s070388s/dib-dcp405plus-/Images/DCP405plus.jpg

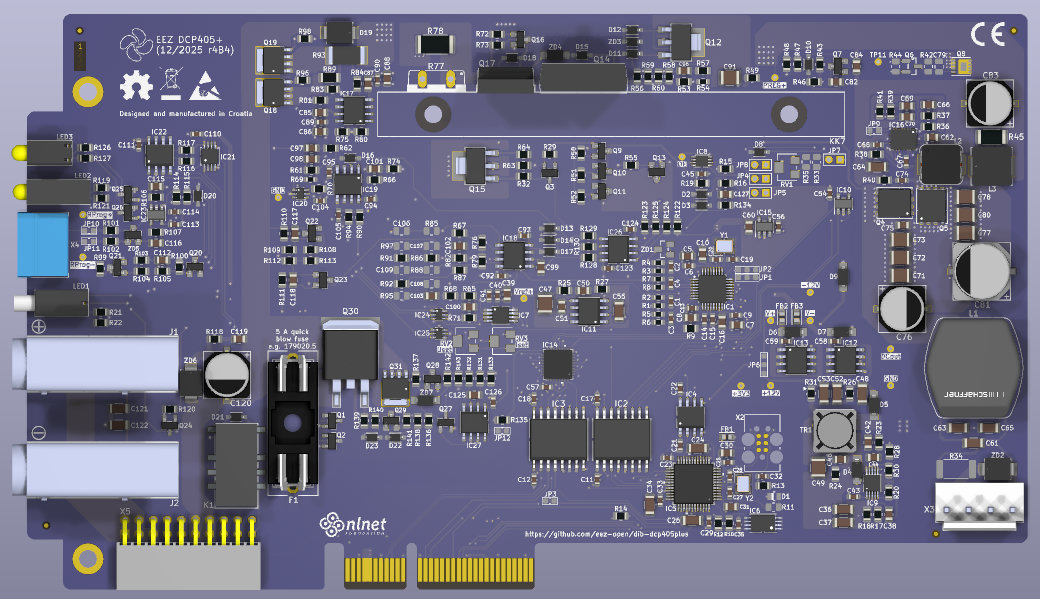
Images/DCP405plus.jpg
