s070388s/dib-dcp405plus-/fabrication/bom/EEZ DIB DCP405plus.pdf

EEZ DIB DCP405plus

# | Reference | Value | Qty | DigiKey | Mouser | TME | LCSC

1 | C14 | 270n | 1
2 | C44 | 33p | 1 | 1276-1105-1-ND | C0805C330K5GACTU | CL21C330JBANNNC
3 | C68 | 15p | 1 | 399-C0603C150J5GAC7867TR-ND 80-C0603C150J5G | C0603C150J5GAC
4 | C81 | EEEFK1J101P | 1 | PCE3819CT-ND | 667-EEE-FK1J101P | EEEFK1J101P
5 | C82 | 470p | 1 | 732-7837-1-ND | 710-885012007038 | CC0805JRNPO9BN471
6 | C97 | 6n8 | 1 | 1276-1799-1-ND | 80-C0805C682K5R | CL21B682KBANNNC
7 | C120 | 33u/50V poly. | 1 | | | - | C2157841
8 | C1,C2,C3,C4,C32,C74 | 1n | 6 | 732-7858-1-ND | 80-C0603C102K5R7040 C0805C102J5GAC
9 | C100,C101,C112 | 2n2 | 3 | 399-C0805C222K5RAC7210TR-ND 80-C0805C222K5RACLR
10 | C19,C20 | 10p | 2 | 1276-1069-1-ND | 187-CL10C100CB8NNNC VJ0603A100JXACW1BC C318677
11 | C24,C26,C36,C37,C64 | 2u2 | 5 | 1276-3138-1-ND | 187-CL31B225KCHSNNE C3216X7S2A225KAB
12 | C27,C28 | 30p | 2 | 1292-1515-1-ND | 80-C0603C300G5HACTU 0603N300J500CT | C123555
13 | C34,C48,C52,C53,C55 | 4u7 | 5 | 1276-2970-1-ND | 963-EMK316B7475ML-T GCM31CR71E475KA55L
14 | | 10n | 9 | 490-7194-1-ND | 710-885012207122 | CC0805KRX7R9103
15 | C46,C102 | 330p | 2 | 1276-1189-1-ND | 80-C0805C331J5G | CL21C331JBANNNC
16 | C47,C49 | 22u | 2
17 | | 1u | 14 | 587-1283-1-ND | | CL21B105KOFNNNE
18 | | 100n | 40 | 490-4774-1-ND | 80-C0603C104M4R | CL10B104KA8NNNC
19 | C61,C63,C65,C121,C122 | 10n/200V | 5 | 311-4491-1-ND | 603-C1206KRX7RABB103 VJ1206Y103KXCTW1BC
20 | C62,C75,C119 | 470n | 3 | 1276-6482-1-ND | 603-CC805KKX7R9BB474 CL21B474KBFNNNE
21 | C70,C103 | 150p | 2 | 1276-1828-1-ND | 80-C0805C151J5G | CC0805JRNPO9BN151
22 | C71,C72,C73,C91 | 4u7/100V | 4 | 587-5034-1-ND | 810-CGA6M3X7S2A475K -
23 | C76,C83 | EEEFK1H470P | 2 | PCE3815CT-ND | 667-EEE-FK1H470P | EEEFK1H470P
24 | C77,C78,C80 | 10u | 3 | 1276-6736-1-ND | 810-C3216X7R1HK160AC CL31A106KBHNNNE
25 | C98,C125,C127 | 4n7 | 3 | 732-12255-1-ND | 810-C2012C0G1H472J-1 GRM2165C1H472JA01D
26 | C99,C115,C116 | 100p | 3 | 399-15000-1-ND | 80-C0805C101K5G | CL21C101JBANNNC
27 | D19 | SK55 | 1 | SK56A-LTPMSCT-ND | 833-SK56A-LTP | SK55-DIO
28 | | BAS316 | 16 | 1727-7370-1-ND | 771-BAS316-T/R | BAS316,115
29 | D4,D5,D6,D7,D9 | SKL16 | 5 | RB160MM-60CT-ND | 755-RB160MM-60TR | SKL16-DIO
30 | F1 | ZH32 | 1 | 732-11370-ND | 710-696101000002 | ZH32
31 | FB1,FB2,FB3 | BLM18AG102SH1D | 3 | 490-7809-1-ND | 81-BLM18AG102SH1D | BLM18AG102SH1D
32 | IC1 | ADS131A04IPBSR | 1 | 296-44202-1-ND | 595-ADS131A04IPBSR | - | C882747
33 | IC4 | ISO6520DR | 1 | 296-ISO6520DRCT-ND | 595-ISO6520DR | - | C32273056

565-HHXD630ARA330MHA0GCT-ND

661-
XD630ARA330MHA0G

C38,C42,C66,C69,C85,C87,C96,C117,C 118

C5,C7,C8,C10,C16,C30,C31,C39,C50,C 51,C60,C84,C86,C88

603-
CC805MKX7R7BB105
C6,C9,C11,C12,C13,C15,C17,C18,C21, C22,C23,C25,C29,C33,C35,C40,C41,C4 3,C45,C54,C56,C57,C58,C59,C67,C89, C90,C92,C93,C94,C95,C104,C105,C110 ,C111,C113,C114,C123,C124,C126

D2,D3,D8,D10,D11,D12,D13,D14,D15,D 16,D17,D18,D20,D21,D22,D23

34 | IC5 | STM32H503CBT6 | 1 | 497-STM32H503CBT6-ND | 511-STM32H503CBT6 | STM32H503CBT6 | C17700273
35 | IC6 | M24C32-DFDW6TP | 1 | 497-16067-1-ND | 511-M24C32-DFDW6TP M24C32-DFDW6TP | C2971426
36 | IC7 | DAC8552IDGKR | 1 | 296-46082-1-ND | 595-DAC8552IDGKR | - | C136020
37 | IC8 | 74AUP1G74DC,125 | 1 | 1727-6029-2-ND | 771-AUP1GDC125 | 74AUP1G74DC.125 | C458192
38 | IC9 | TPS54060DGQ | 1 | 296-37148-1-ND | TPS54060ADGQR | - | C12382
39 | IC10 | TC77-5.0MCTTR | 1 | TC77-5.0MCTTRCT-ND | 579-TC77-5.0MCTTR | TC77-5.0MCTTR | C145382
40 | IC11 | REF5025AIDR | 1 | 296-39165-1-ND | 595-REF5025AIDR | - | C11341
41 | IC12 | MC79L05 | 1 | MC79L05ABDGOS-ND | 863-MC79L05ACDR2G | MC79L05ACDG | C232661
42 | IC13 | MC78L05 | 1 | MC78L05ACDR2GOSCT-ND | 863-MC78L05ACDR2G | MC78L05ACDG | C7371
43 | IC14 | PCAL9722HNMP | 1 | 568-PCAL9722HNMPTR-ND | 771-PCAL9722HNMP | - | C24212503
44 | IC15 | TPS7A2033PDBVR | 1 | 296-TPS7A2033PDBVRCT-ND | 595-TPS7A2033PDBVR | TPS7A2033PDBVR | C2862740
45 | IC16 | LM5145RGYR | 1 | 296-47661-1-ND | 595-LM5145RGYR | - | C485912
46 | IC17 | LTC2050HVCS8#PBF | 1 | LTC2050HVCS8#PBF-ND | 584-LTC2050HVCS8#PBF - | C679141
47 | IC21 | SN74LVC2G08DCTR | 1 | 296-13263-2-ND | 595-SN74LVC2G08DCTR SN74LVC2G08DCTR | C352973
48 | IC23 | OPA376AIDBVR | 1 | 296-39130-2-ND | 595-OPA376AIDBVR | OPA376AIDBVR | C42134
49 | IC27 | MAX9141ESA | 1 | MAX9141ESA+-ND | 700-MAX9141ESA | - | C3658498
50 | IC18,IC19 | TL072D | 2 | 296-1282-1-ND | 595-TL072CDR | TL072CD-ST | C67473
51 | IC2,IC3 | ISO6762FDWR | 2 | 296-ISO6762FDWRCT-ND | 595-ISO6762FDWR | - | C5216396
52 | IC20,IC24,IC25 | SN74LVC1G3157DCKR | 3 | 296-14909-1-ND | SN74LVC1G3157DCKR C38663
53 | IC22,IC26 | LM293D | 2 | LM293DR2GOSCT-ND | 863-LM293DR2G | LM293DR | C76509
54 | J1 | 572-0500 | 1 | - | 164-6221 | 572-0500 | -
55 | J2 | 572-0100 | 1 | - | 164-6220 | 572-0100 | -
56 | K1 | | 1 | 399-10997-1-ND | 80-EE2-12NU-L | FTR-C1GA012G-B05 | C147864
57 | KK7 | SK96/84 | 1 | 5496-SK9684SA-ND | - | SK96/84SA | -
58 | KK8 | SP400-0.007-00-104 | 1 | BER204-ND | 951-SP400-007-00-104
59 | KK1,KK2 | PCB-MB-01 | 2 | RPC1760-ND | 144-PCB-MB-01 | RI-PCB-MB-01
60 | KK3,KK4,KK5,KK9 | M3X8/D7985B | 4 | - | - | M3X8/D7985B
61 | KK6,KK10 | B3/BN2842 | 2 | - | - | B3/BN2842
62 | L1 | RN112-4-02-0M7 | 1 | 817-2100-ND | 631-RN112-4-02-0M7 | -
63 | L2 | ETQ-P4M100KFM | 1 | P124167CT-ND | 667-ETQ-P4M100KFM | -
64 | L3 | HPI0630-3R3 | 1 | 445-180834-1-ND | 810-VLS6045AF-3R3N | HPI0630-3R3
65 | LED1 | WP42WUM/EGW | 1 | 754-1718-ND | 604-WP42WUM/EGW | L-42WUM/1EGWT
66 | LED2 | SSF-LXH340LYGID | 1 | SSF-LXH340LYGID-ND | 696-SSFLXH340LYGID | - | C17285042
67 | LED3 | WP934MD/LYLID | 1 | 350-2716-ND | 604-WP934MDLYLID | - | -
68 | Q4 | BSC117N08NS5ATMA1 | 1 | BSC117N08NS5ATMA1CT-ND | BSC117N08NS5ATMA1 C3278730
69 | Q5 | BSC039N06NSATMA1 | 1 | BSC039N06NSATMA1CT-ND | | BSC039N06NS | C6471340
70 | Q14 | IRFP250NPBF | 1 | IRFP250NPBF-ND | 942-IRFP250NPBF | IRFP250NPBF
71 | Q16 | BC857C | 1 | 4878-BC857CCT-ND | 637-BC857C | BC857C-DIO | C8666
72 | Q17 | IRFI9Z34GPBF | 1 | IRFI9Z34GPBF-ND | 844-IRFI9Z34GPBF | IRFI9Z34GPBF | C222460
73 | Q29 | FMMT493TA | 1 | FMMT493CT-ND | 522-FMMT493TA | FMMT493TA
74 | Q30 | BT139B-600E | 1 | 1740-1053-1-ND | 771-BT139B-600E118 | BT139B-600E.118 | C6533556

595-
SN74LVC1G3157DCK

FTR-C1GA012G-B05 or
EE2-12NU-L

726-
BSC117N08NS5ATMA
726-
BSC039N06NSATMA1

75 | Q31 | PSMN013-60YL | 1 | 1727-2589-1-ND | 771-PSMN013-60YLX | PSMN013-60YLX | C503662
76 | Q1,Q2,Q3 | BSS84 | 3 | BSS84LT1GOSCT-ND | 863-BSS84LT1G | BSS84LT1G | C82079
77 | Q12,Q15 | BCP56-16.115 | 2 | BCP5616QTADICT-ND | 621-BCP5616QTA | BCP56-16T1G
78 | Q18,Q19 | PSMN0R9-25YLC | 2 | 1727-5292-1-ND | 771-PSMN0R925YLC115 PSMN0R9-25YLC.115
79 | Q24,Q25,Q26,Q27 | 2N7002 | 4 | T2N7002AKLMCT-ND | 757-T2N7002AKLM | 2N7002LT1G
80 | Q7,Q10,Q11,Q23 | MMBT5401 | 4 | MMBT5401-FDICT-ND | 621-MMBT5401-F | MMBT5401-DIO | C21488
81 | Q9,Q13,Q20,Q21,Q22,Q28 | MMBT5551 | 6 | MMBT5551LT1GOSCT-ND | 637-MMBT5551 | MMBT5551-DIO | C41095
82 | R20 | 330K | 1 | A126361CT-ND | 652-CR0805FX-3303ELF 0805S8F3303T5E
83 | R45 | 15R | 1 | A129910CT-ND | 603-RC2010FK-0715RL | 201007J0150T4E
84 | R53 | 51K | 1
85 | R59 | 16K | 1
86 | R68 | 6K8 | 1
87 | R69 | 3K | 1
88 | R78 | 2R2/2-3W | 1 | CRM2512-JW-2R2ELFCT-ND | 279-35222R2JT | WF25P2R2JTL
89 | R89 | 1R 0.1% | 1 | 1712-CPF1206B1R0E1CT-ND | 279-CPF1206B1R0E1 | - | C4106088
90 | R93 | 0R010 | 1 | 846-GMR100HJBFA10L0CT-ND | GMR100HJBFA10L0 | - | -
91 | R141 | 6R2 | 1 | 311-6.20CRCT-ND | 603-RC0805FR-076R2L | RC0805JR-076R2
92 | R1,R2,R3,R4,R5,R6,R7,R8,R54 | 100R | 9 | 13-RC0603FR-10100RLCT-ND | 603-RT0603FRE07100RL RC0603FR-10100RL | C1512171
93 | | 2K2 | 10 | 311-2.20KCRCT-ND | 603-RC0805FR-072K2L | 0805S8F2201T5E
94 | R110,R111,R131 | 330R | 3 | A129743CT-ND | 652-CR0805FX-3300ELF 0805S8F3300T5E
95 | R116,R117,R134 | 4K7 | 3 | 311-4.70KCRCT-ND | 603-RC0805FR-074K7L | 0805S8F4701T5E
96 | | 10K | 26 | 311-10.0KCRCT-ND | 603-RC0805FR-0710KL | RC0805FR-1310KL
97 | R15,R29,R46,R120,R138 | 100K | 5 | RMCF0805FT100KCT-ND | 0805S8F1003T5E
98 | 47K | 9 | RHM47KKCT-ND | 603-RC0805FR-0747KL | RC0805FR-0747K
99 | R21,R60,R109,R112,R126,R127 | 750R | 6 | A126385CT-ND | 0805S8F7500T5E | C17818
100 | R22,R30,R75,R124,R125 | 6K2 | 5
101 | R23,R28 | 86K6 | 2 | 311-86.6KCRCT-ND | 603-RT0805FRE0786K6L CRCW080586K6FKTABC
102 | R27,R118 | 1R | 2 | -
103 | R38,R55,R61,R119 | 470R | 4 | 311-470CRCT-ND | 71-CRCW0805470RFKEB RC0805FR-07470R
104 | R41,R122,R123 | 3K9 | 3 | A126369CT-ND | 279-CRGP0805F3K9 | SMD0805-3K9-1%
105 | 1K | 12 | RC0805FR-071KL | 603-RC0805FR-071KL | RC0805FR-071K
106 | R50,R121 | 1K2 | 2
107 | R51,R52,R64,R94 | 220R | 4 | RMCF0805FT220RCT-ND | 603-RC0805FR-13220RL 0805S8F2200T5E
108 | R79,R82 | 7K5 0.1% | 2 | YAG1974CT-ND | 279-CPF0805B7K5E1 | AR05BTCW7501
109 | R80,R81 | 36K 0.1% | 2 | YAG4886CT-ND | 603-RT0805BRD0736K5L - | C865431
110 | R83,R84 | 750R 0.1% | 2 | YAG4940CT-ND | 603-RT0805BRD07750RL ERA6AEB751V | C728656

R10,R12,R17,R58,R66,R71,R72,R73,R7 4,R113

R13,R14,R16,R19,R32,R36,R39,R43,R4 7,R65,R76,R90,R99,R101,R102,R103,R 106,R107,R128,R129,R130,R132,R133, R135,R142,R143
71-
CRCW0805100KFKEAC
R18,R37,R57,R70,R96,R98,R100,R104, R105
71-
CRCW0805750RFKEAC

R48,R56,R62,R63,R67,R108,R114,R115 ,R136,R137,R139,R140

111 | R86,R87 | 100K 0.1% | 2
112 | R9,R24,R25,R26,R31,R40,R49 | 10R | 7 | | | SMD0805-10R-1%
113 | R91,R92 | 24K 0.1% | 2
114 | TR1 | SRF0703-821M | 1 | SRF0703-821MCT-ND | 652-SRF0703-821M | -
115 | X3 | B4P-VH (LF)(SN) | 1 | | | B4P-VH (LF)(SN)
116 | X4 | TBP03R1-350-03BE | 1 | 2223-TBP03R1-350-03BE-ND | 179-TBP03R1-350-03BE - | C3581987
117 | X5 | ZL263-20DG | 1 | PPPC102LJBN-RC | - | ZL263-20DG | C239361
118 | Y1 | | 1 | 535-14398-1-ND | 815-ABM825MHZD2XT | - | C1986777
119 | Y2 | | 1 | 535-14398-1-ND | 815-ABM825MHZD2XT | - | C1986777
120 | ZD3 | BZX384-C15 | 1 | 1727-4986-1-ND | 78-BZX384C15-E3-08 | BZX384-C15.115 | C454989
121 | ZD4 | BZT52C6V2 | 1 | 4878-BZT52C6V2CT-ND | 621-BZT52C6V2-13-F | BZT52C6V2GW | C397931
122 | ZD5 | SLVU2.8.TCT | 1 | CDSOT23-SLVU2.8TR-ND | 652-CDSOT23-SLVU2.8 SLVU2.8.TCT
123 | ZD7 | MMSZ5230BT1G | 1 | MMSZ5230BT1GOSCT-ND | 863-MMSZ5230BT1G | MMSZ5230BT1G
124 | ZD2,ZD6 | P6SMB68A | 2 | P6SMB68ABBCT-ND | 652-P6SMB68A | P6SMB68A-LF | C126829

ECS-163.84-10-33-JGN-TR
ABM8-25.000MHZ-D2X-T
