s070388s/dib-dcp405plus-/fabrication/step/EEZ DIB DCP405plus front mask.step

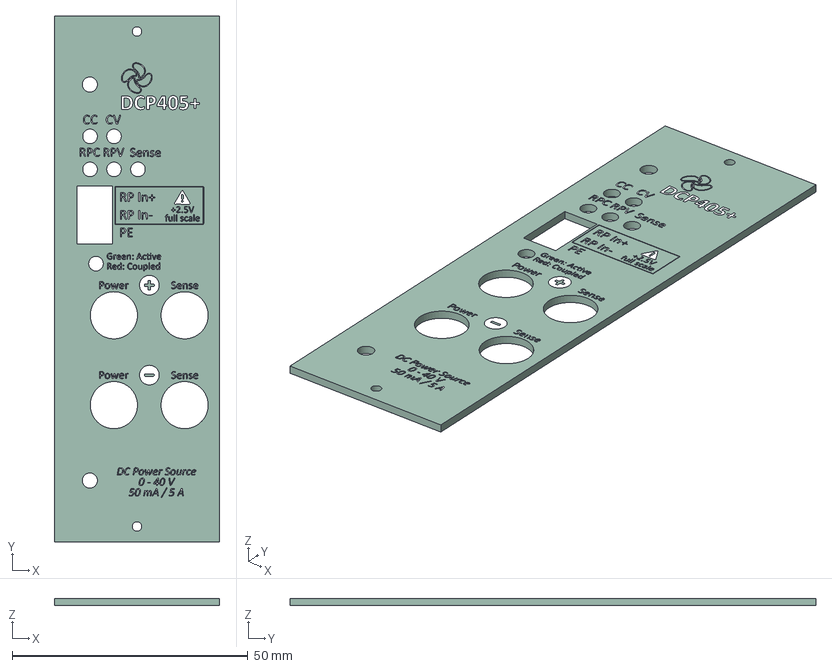
[picture p7: CAD file, 2025-12-13]
fabrication/step/EEZ DIB DCP405plus front mask.step
35.0 x 111.5 x 1.58 mm
EEZ DIB DCP405plus front mask_silkscreen
EEZ DIB DCP405plus front mask_PCB
