s070388s/dib-dcp405plus-/(list of files, cad)

Other CAD files:
fabrication/dxf/EEZ DIB DCP405plus front mask.dxf
