s070388s/dib-dcp405plus-/fabrication/front mask/DCP405plus front mask.png

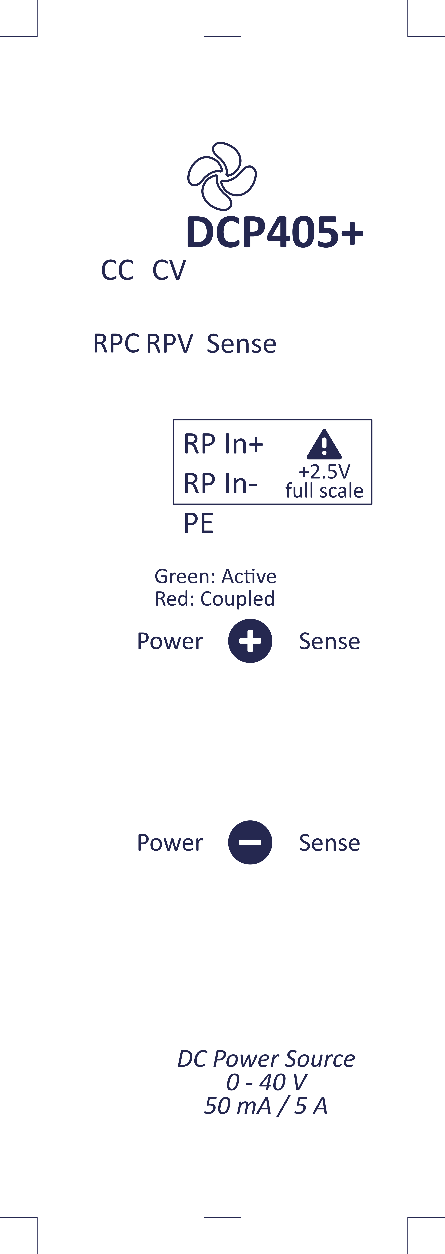
fabrication/front mask/DCP405plus front mask.png
