s070388s/dib-dcp405plus-/schematic-diagram/EEZ DIB DCP405plus.pdf

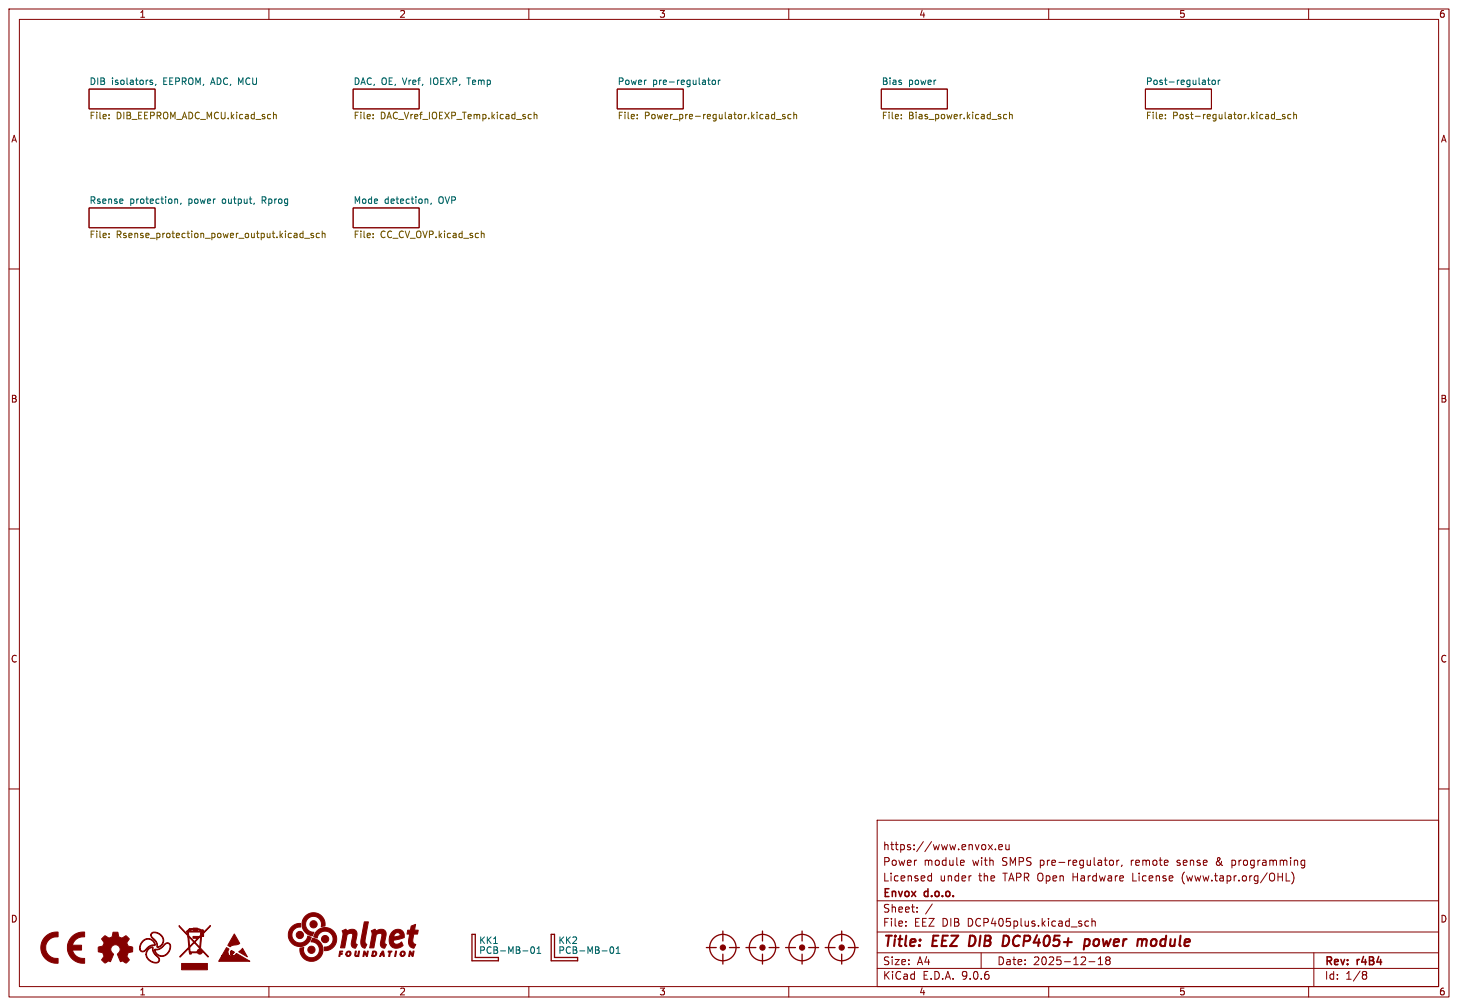
[picture p9: page 1]

Post-regulator File: Post-regulator.kicad_sch

https://www.envox.eu

KK2 PCB-MB-01 KK1 PCB-MB-01

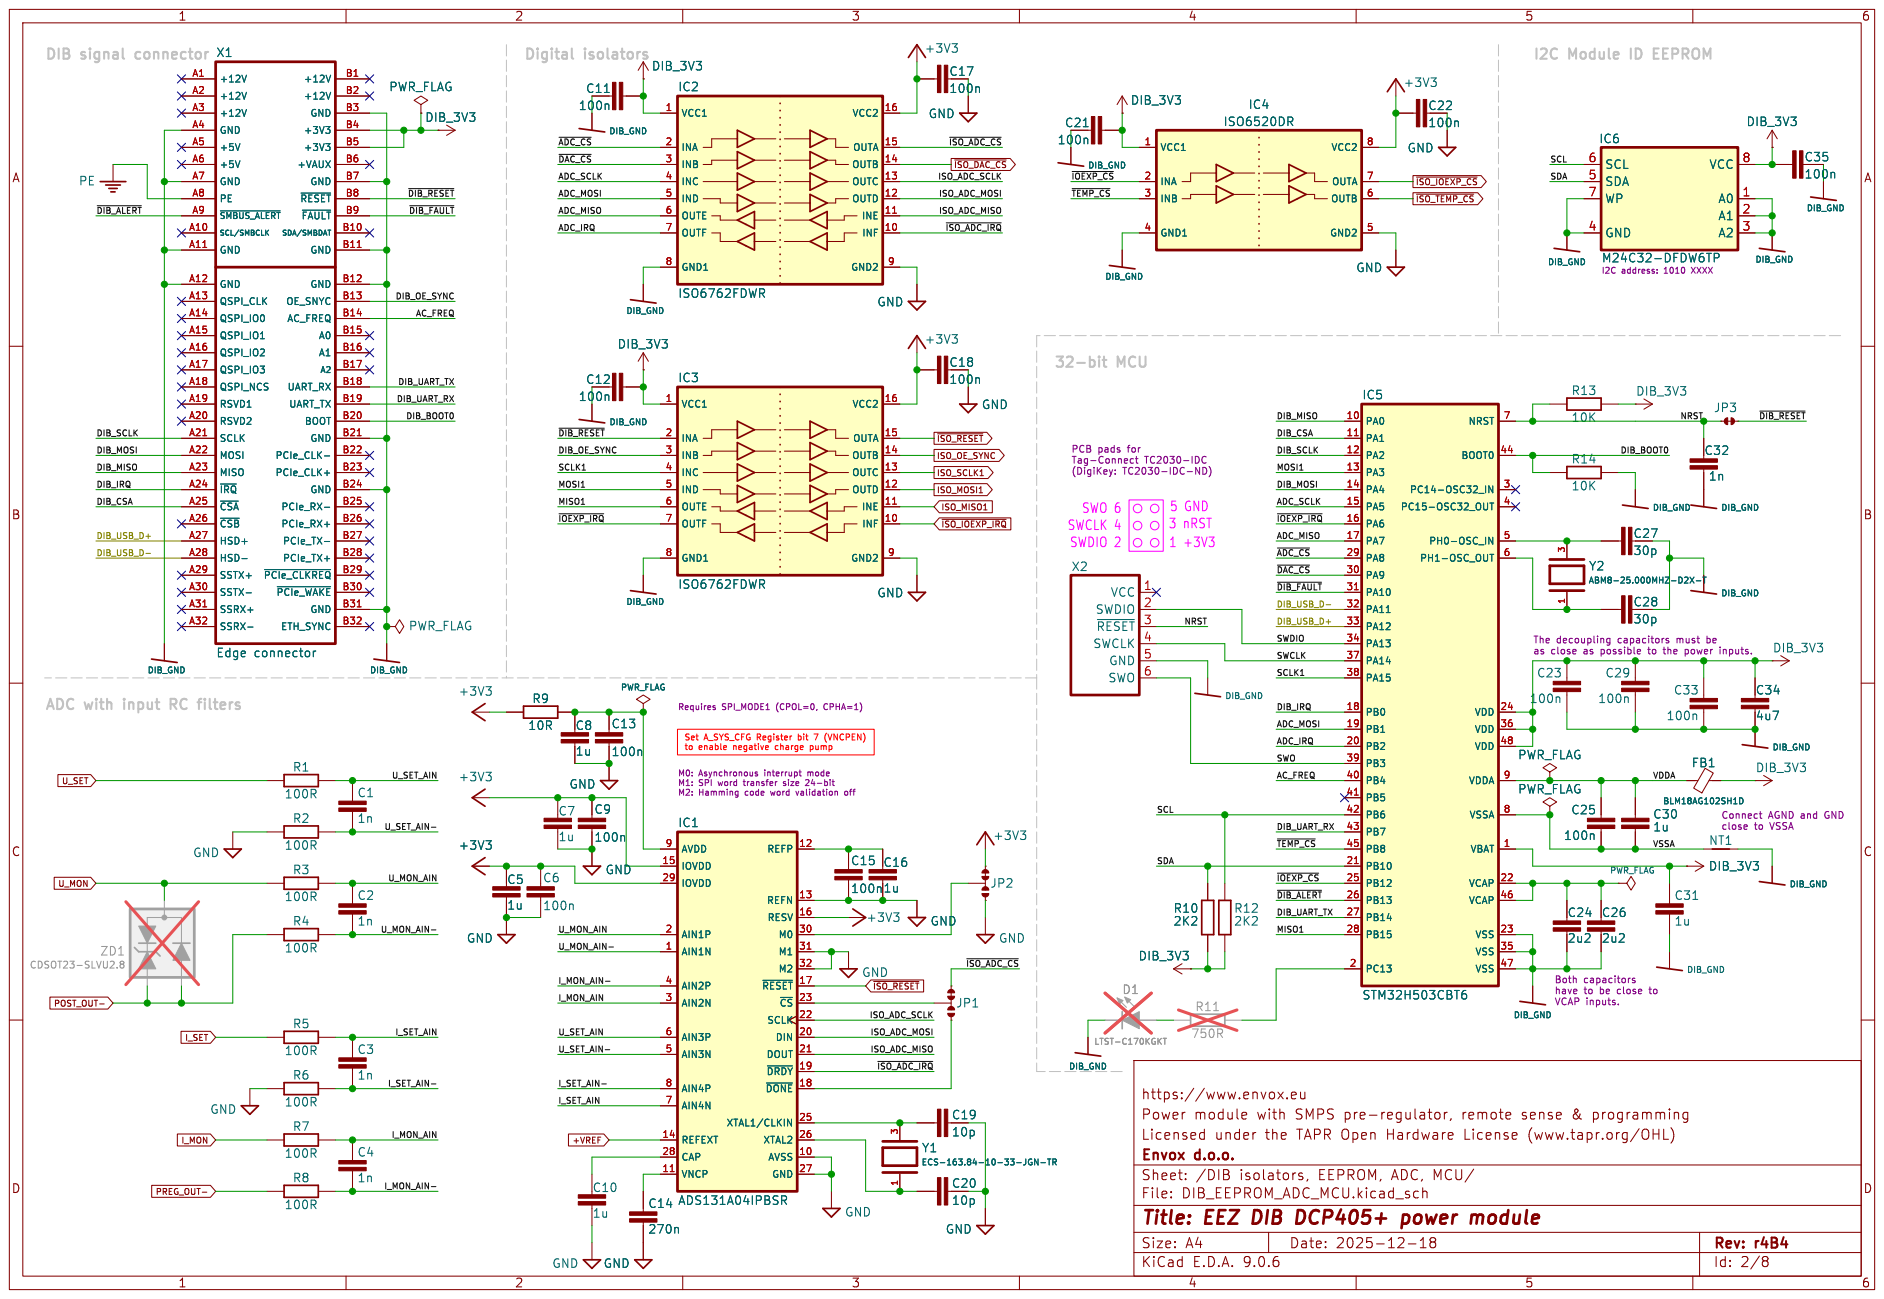
[picture p10: page 2]

2K2 VCC 1 SWDIO 2 ~{RESET}3 SWCLK 4 GND 5 SWO 6 X2

close to VSSA ADC with input RC filters

Both capacitors have to be close to VCAP inputs.

https://www.envox.eu

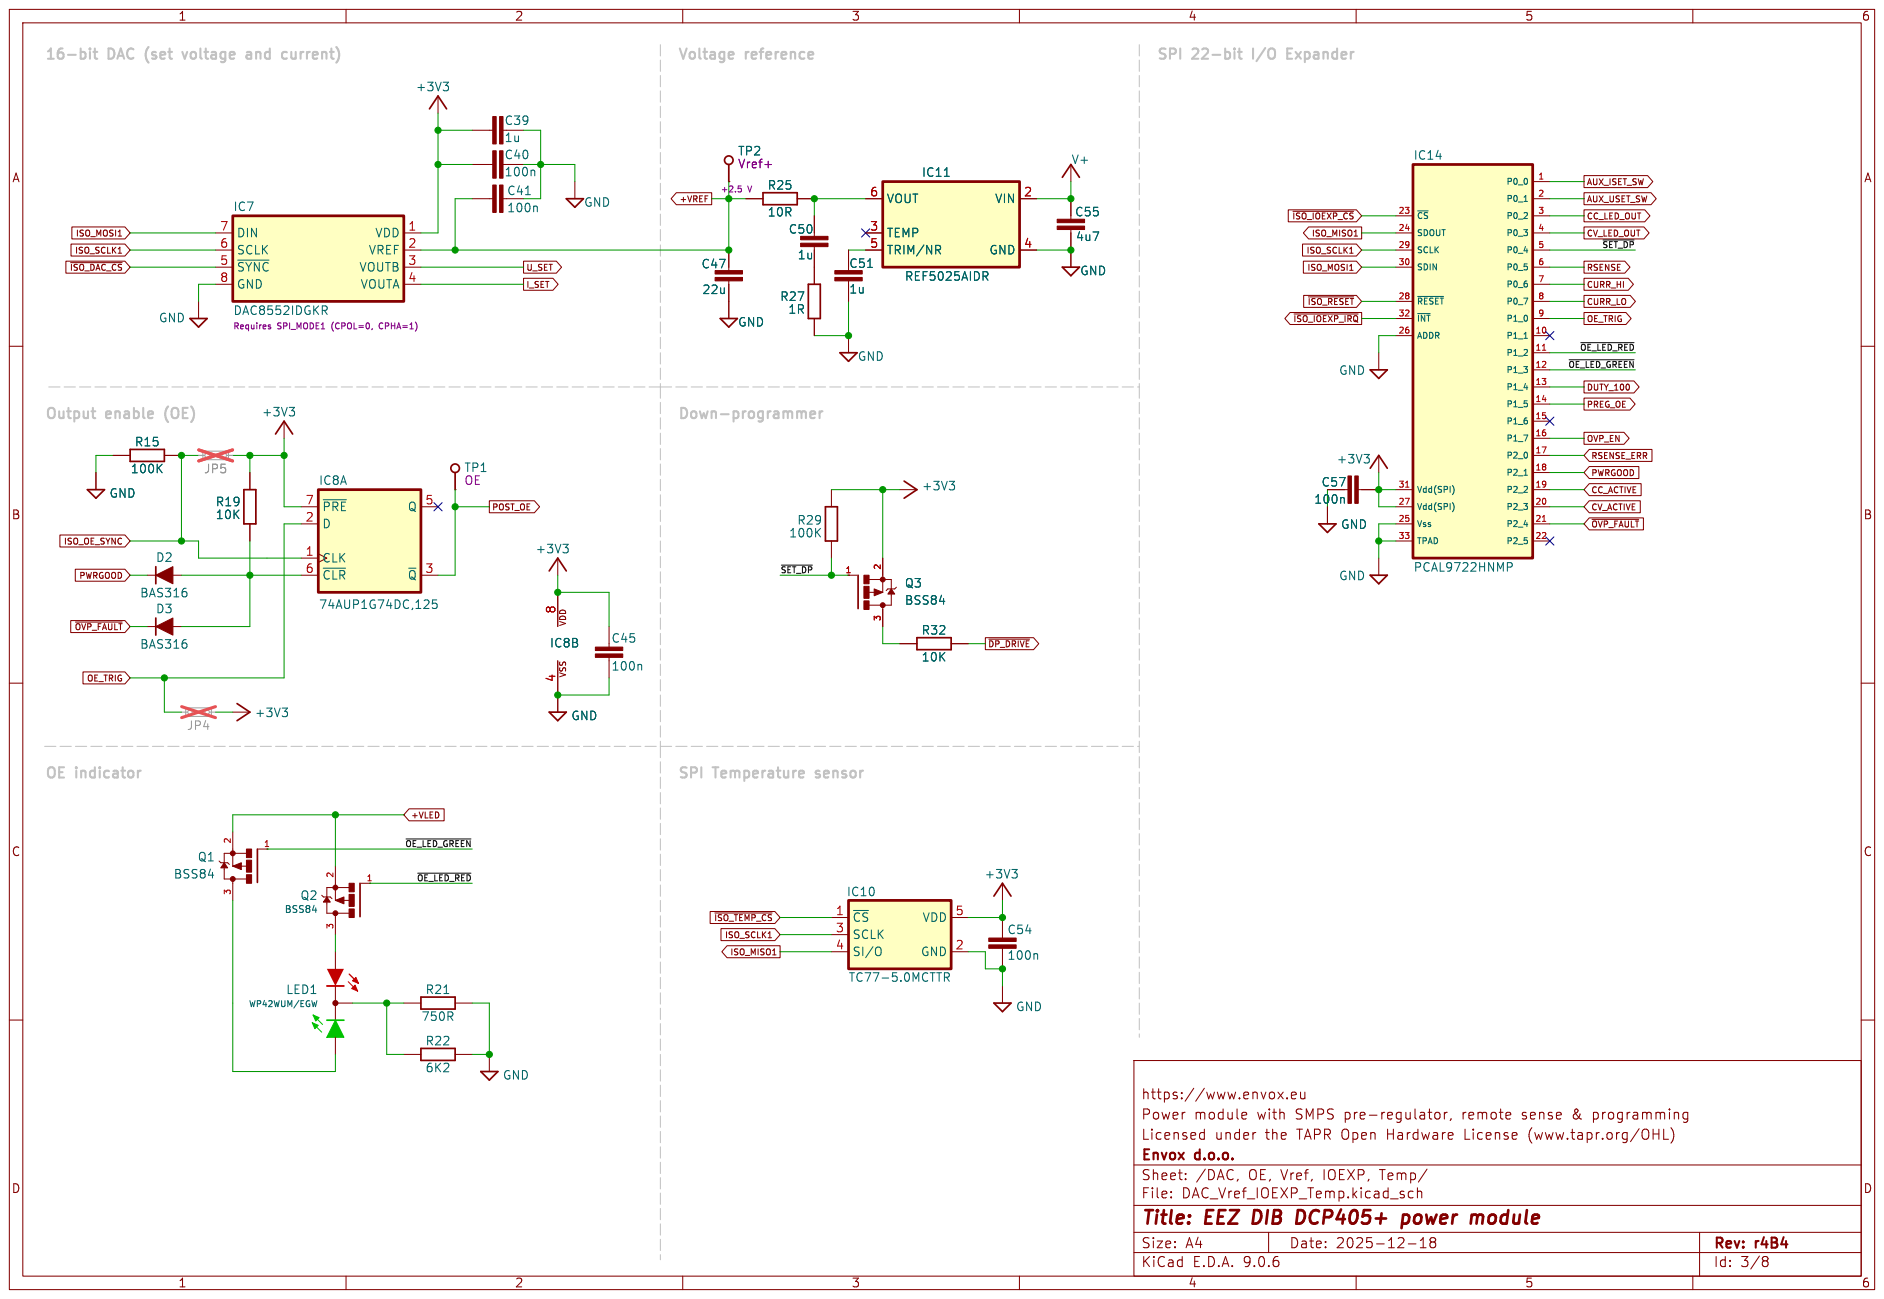
[picture p11: page 3]

VIN 2 GND 4 VOUT 6 TEMP 3 TRIM/NR 5 TP2 Vref+ C47

VDD 1 VREF 2 VOUTB 3 VOUTA 4 DIN 7 SCLK 6 ~{SYNC} 5 GND 8

https://www.envox.eu

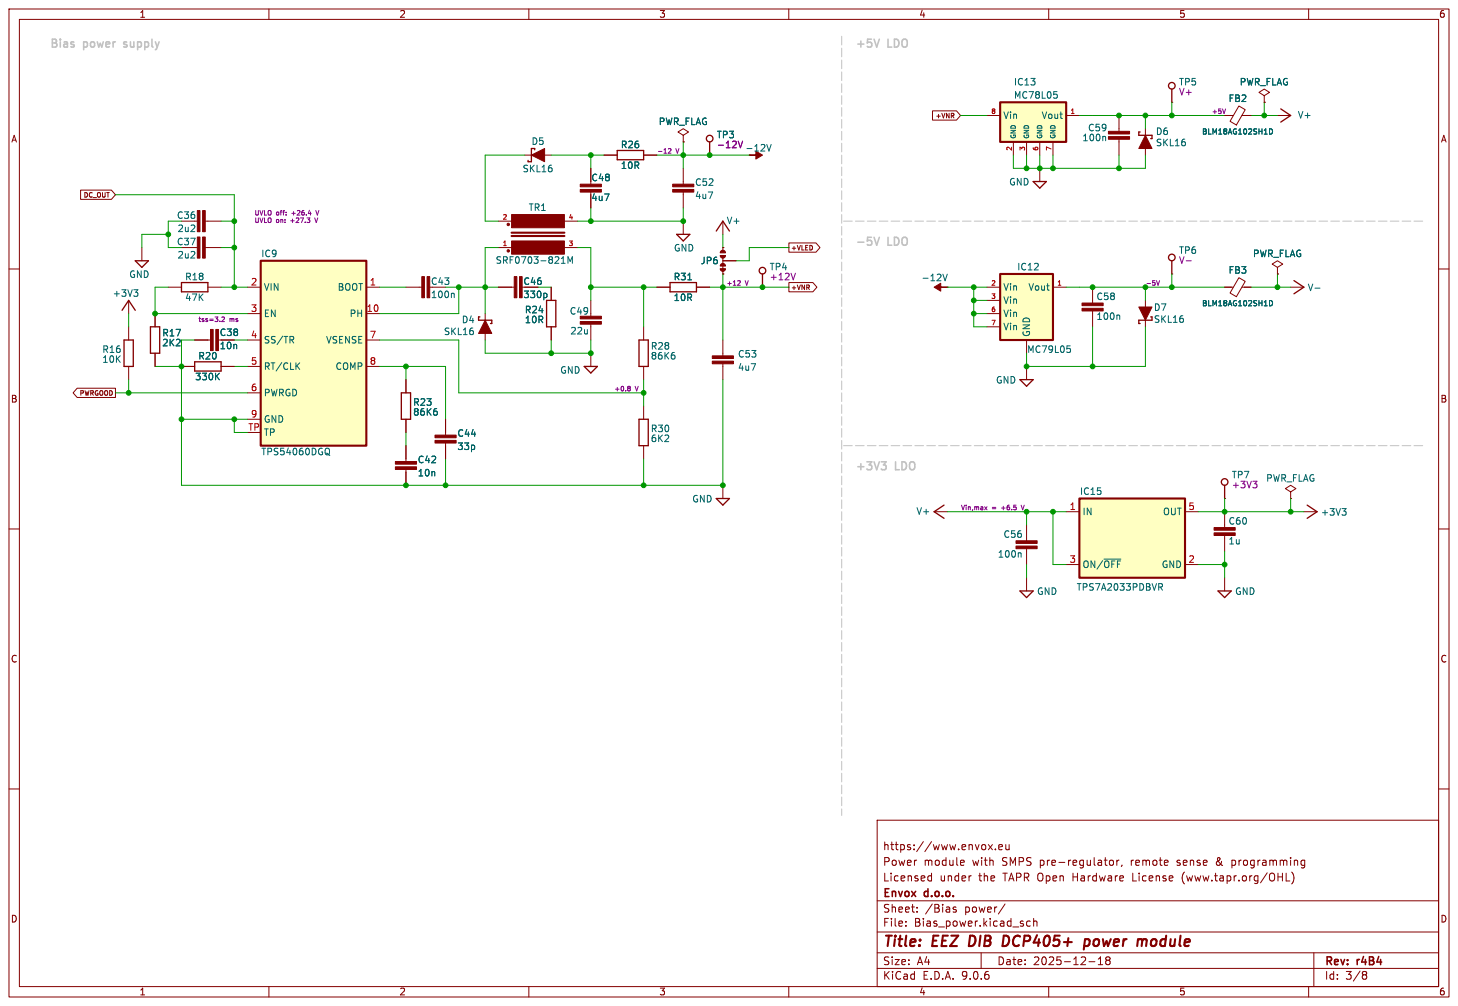
[picture p12: page 4]

https://www.envox.eu

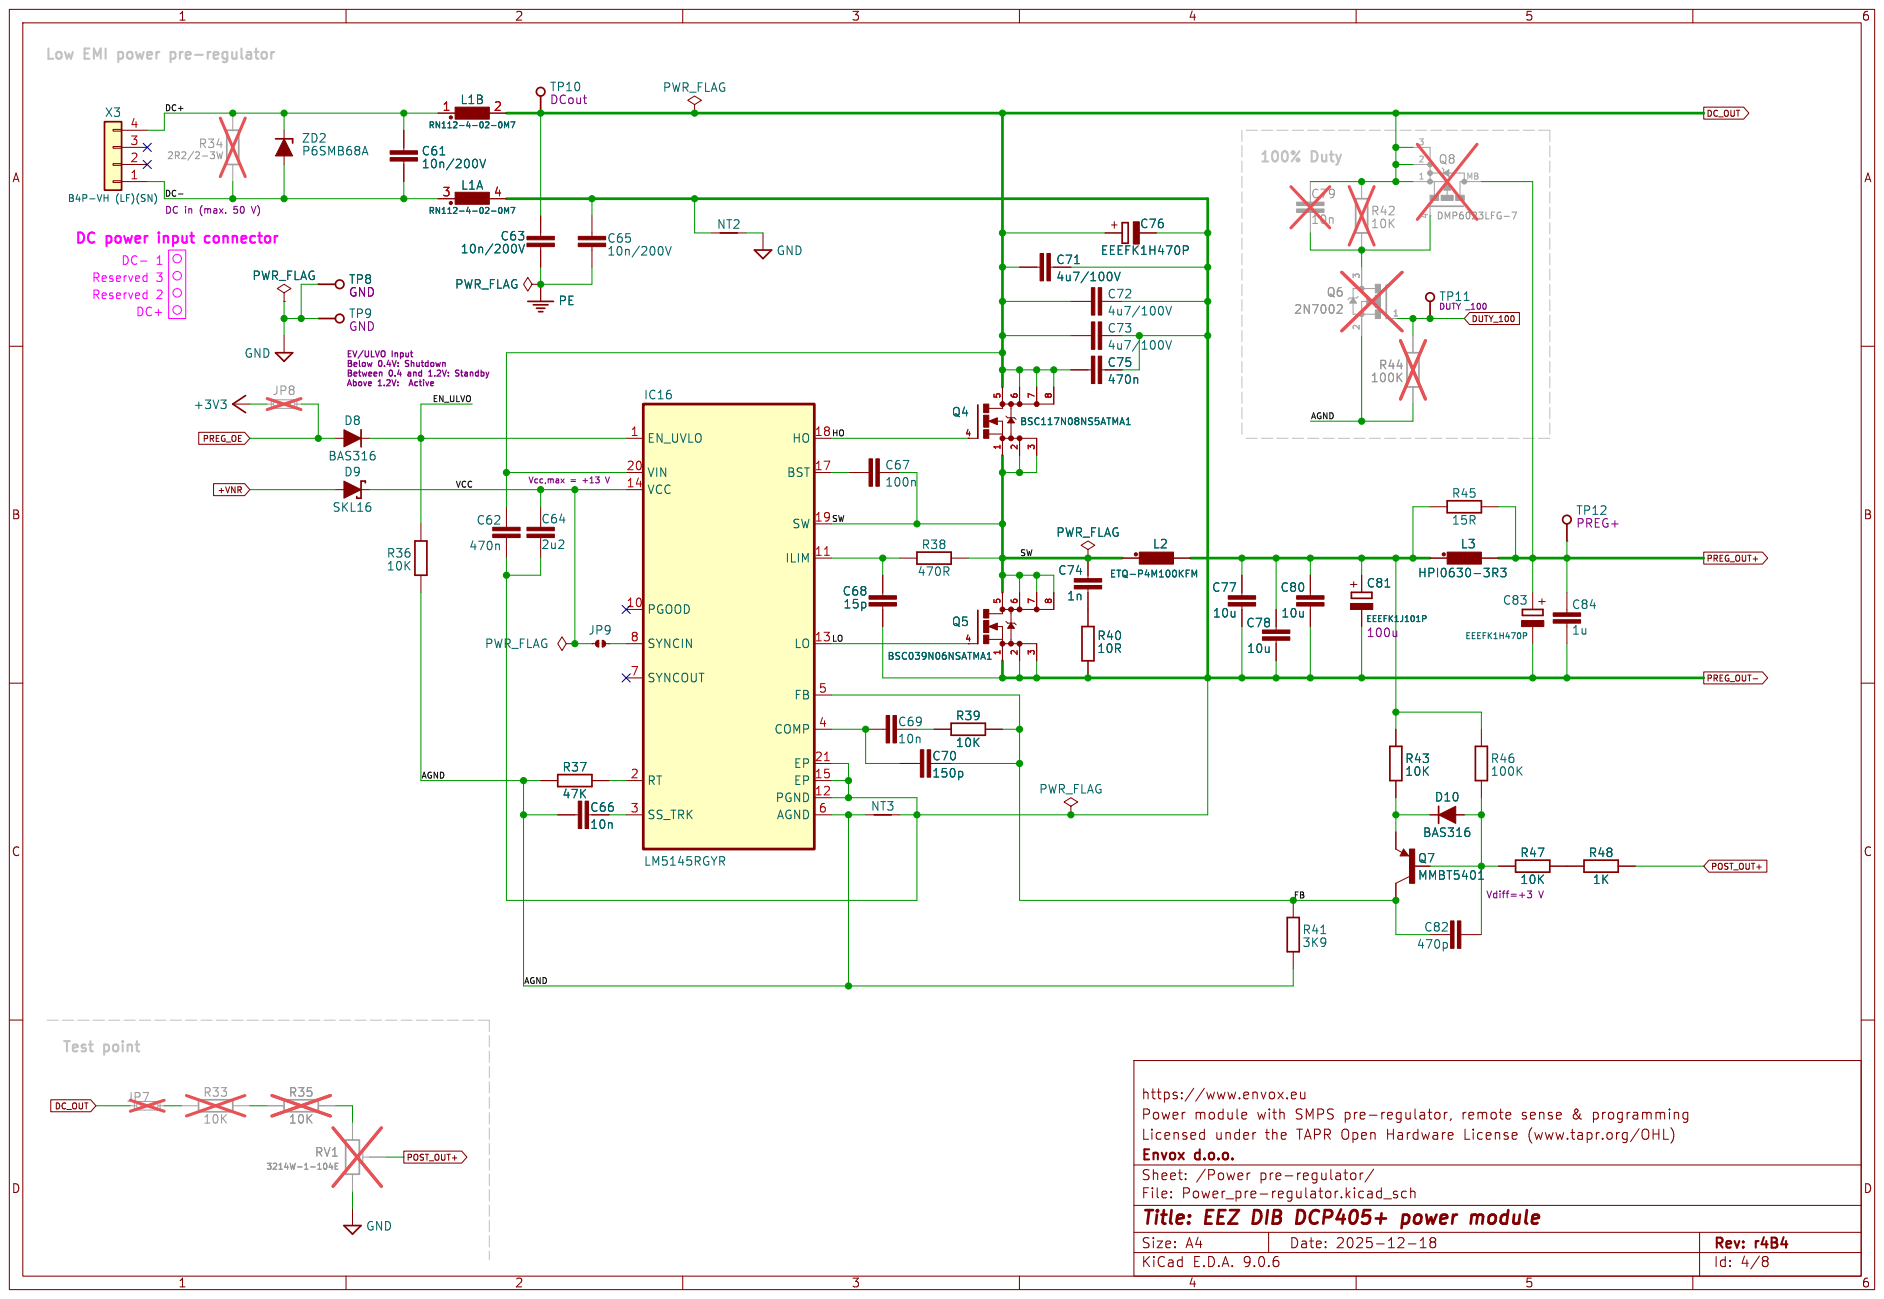
[picture p13: page 5]

ILIM 11
LO 13 FB 5 COMP 4 EP 21 EP 15 PGND 12 AGND 6

https://www.envox.eu RV1

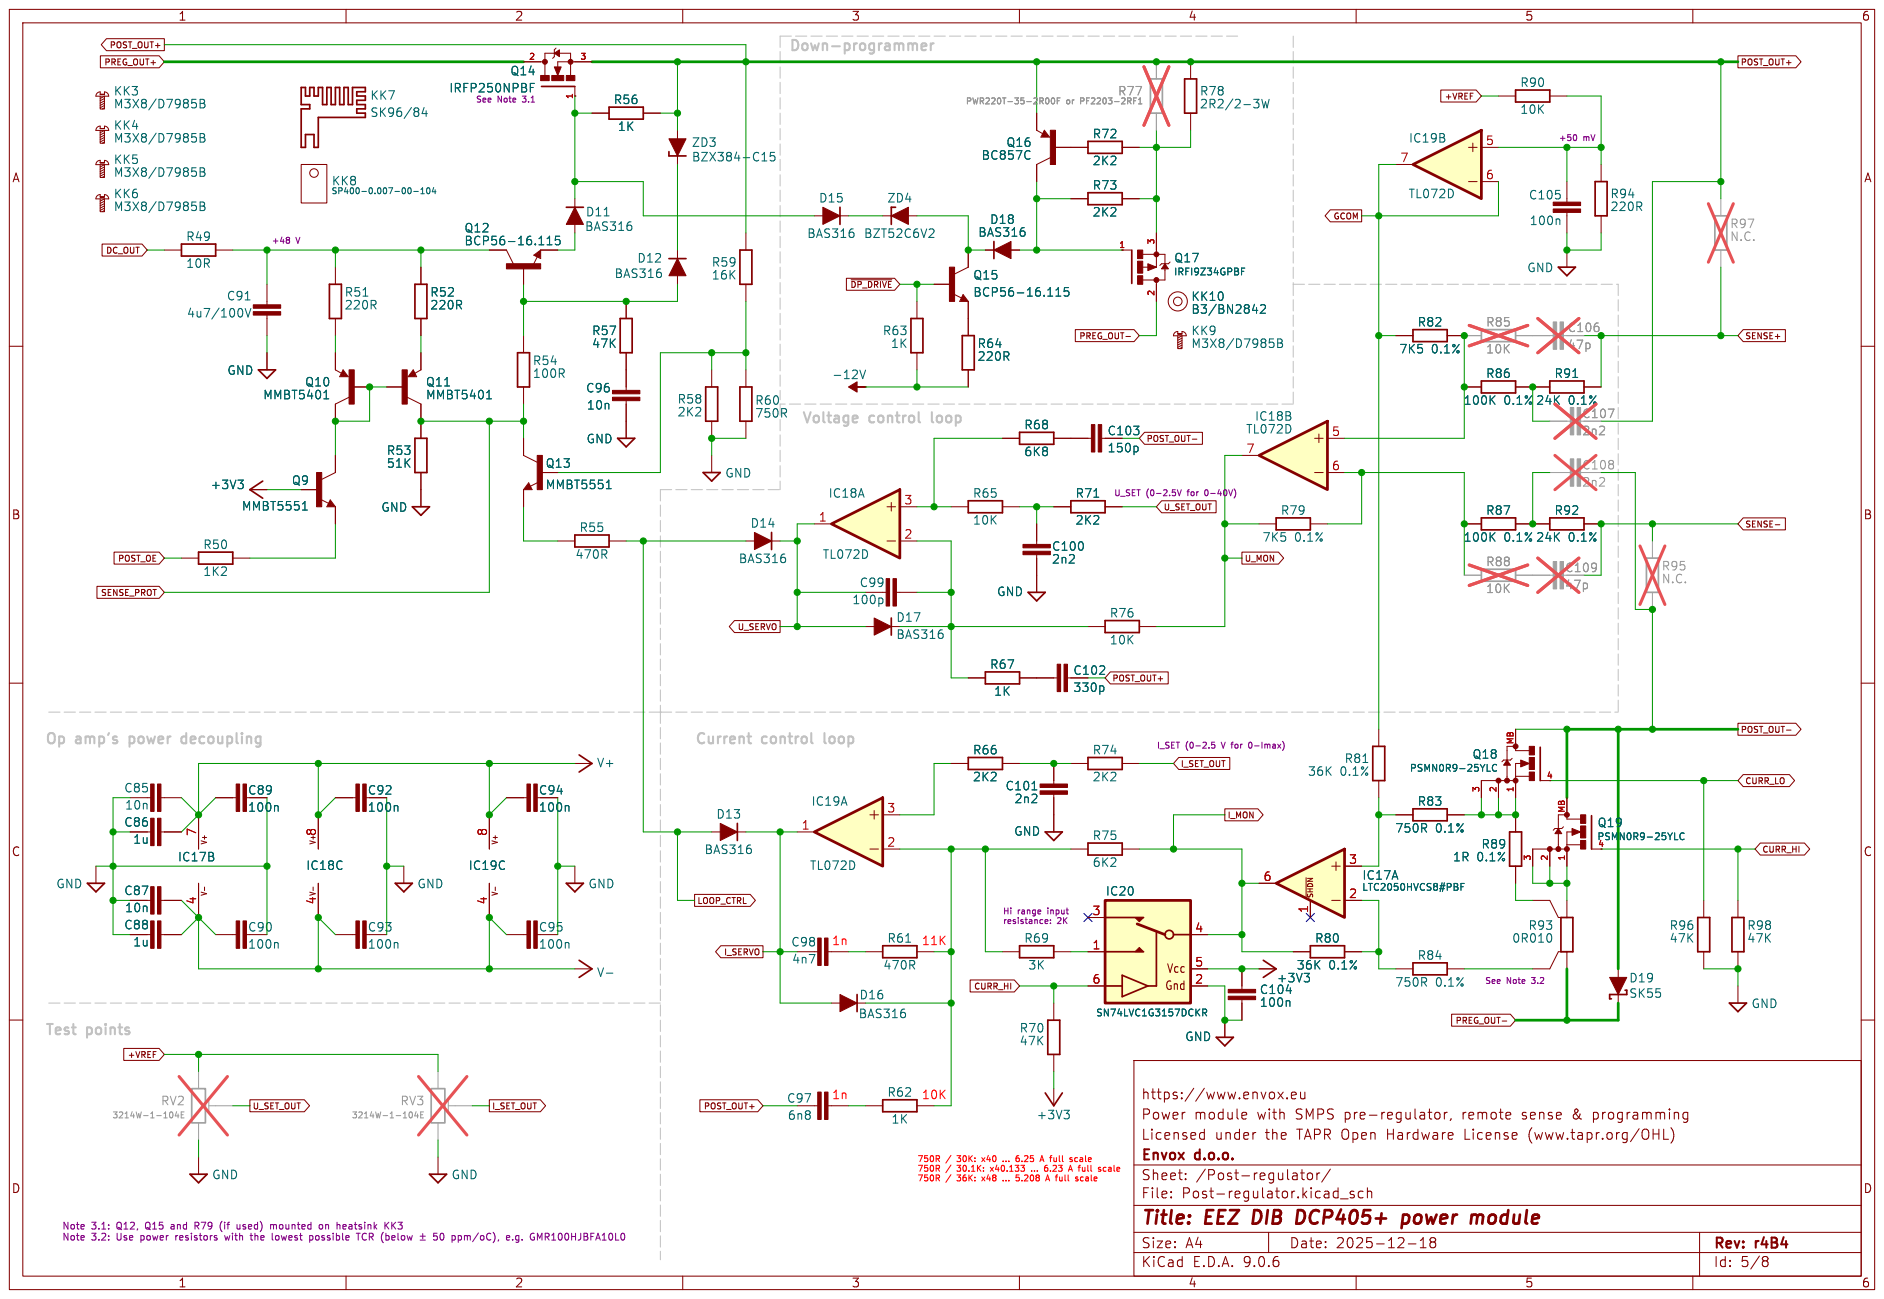
[picture p14: page 6]

https://www.envox.eu C88

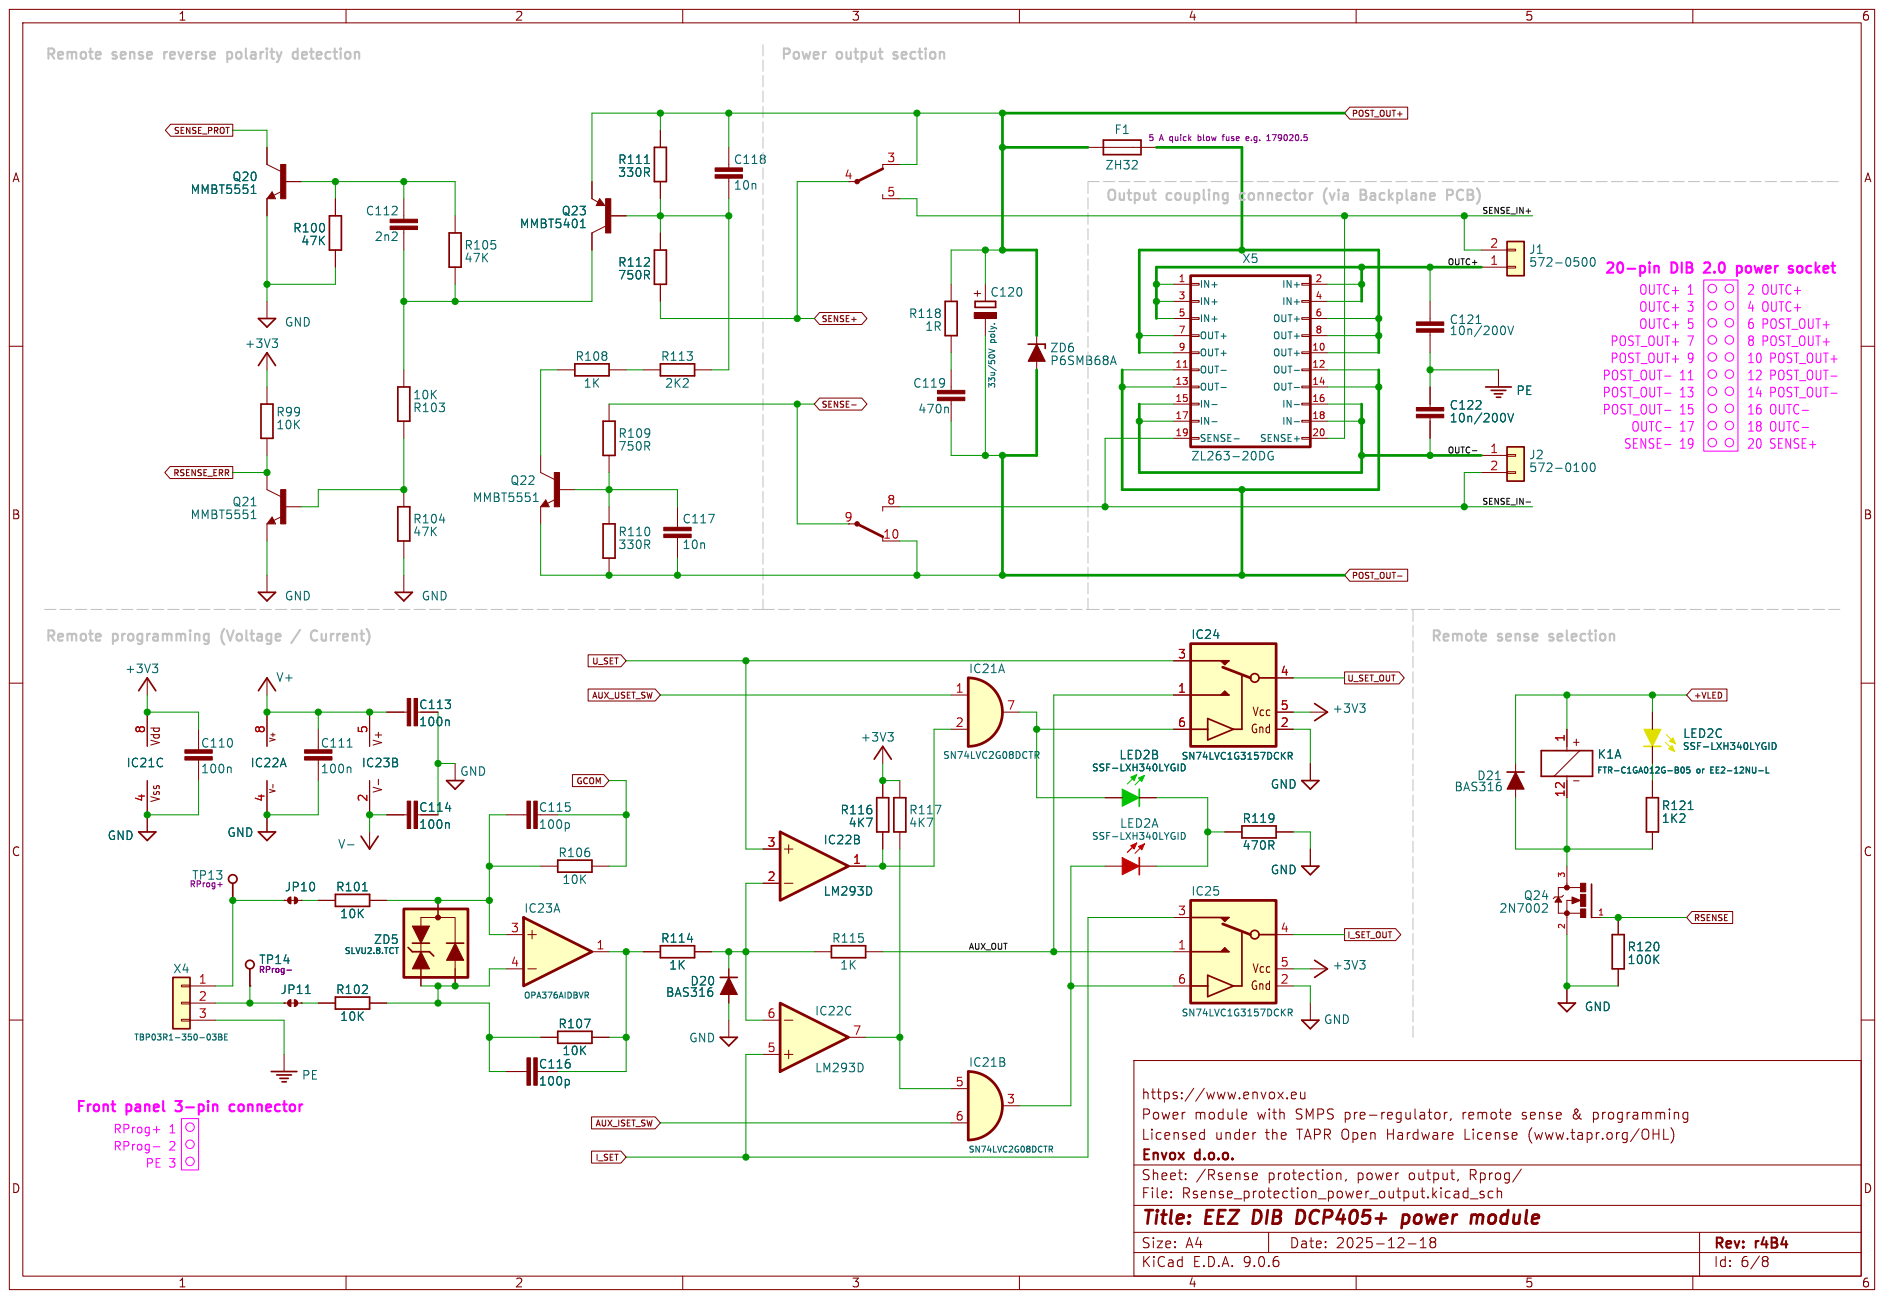
[picture p15: page 7]

POST_OUT- 13 OUTC- 17 Output coupling connector (via Backplane PCB)

https://www.envox.eu R110

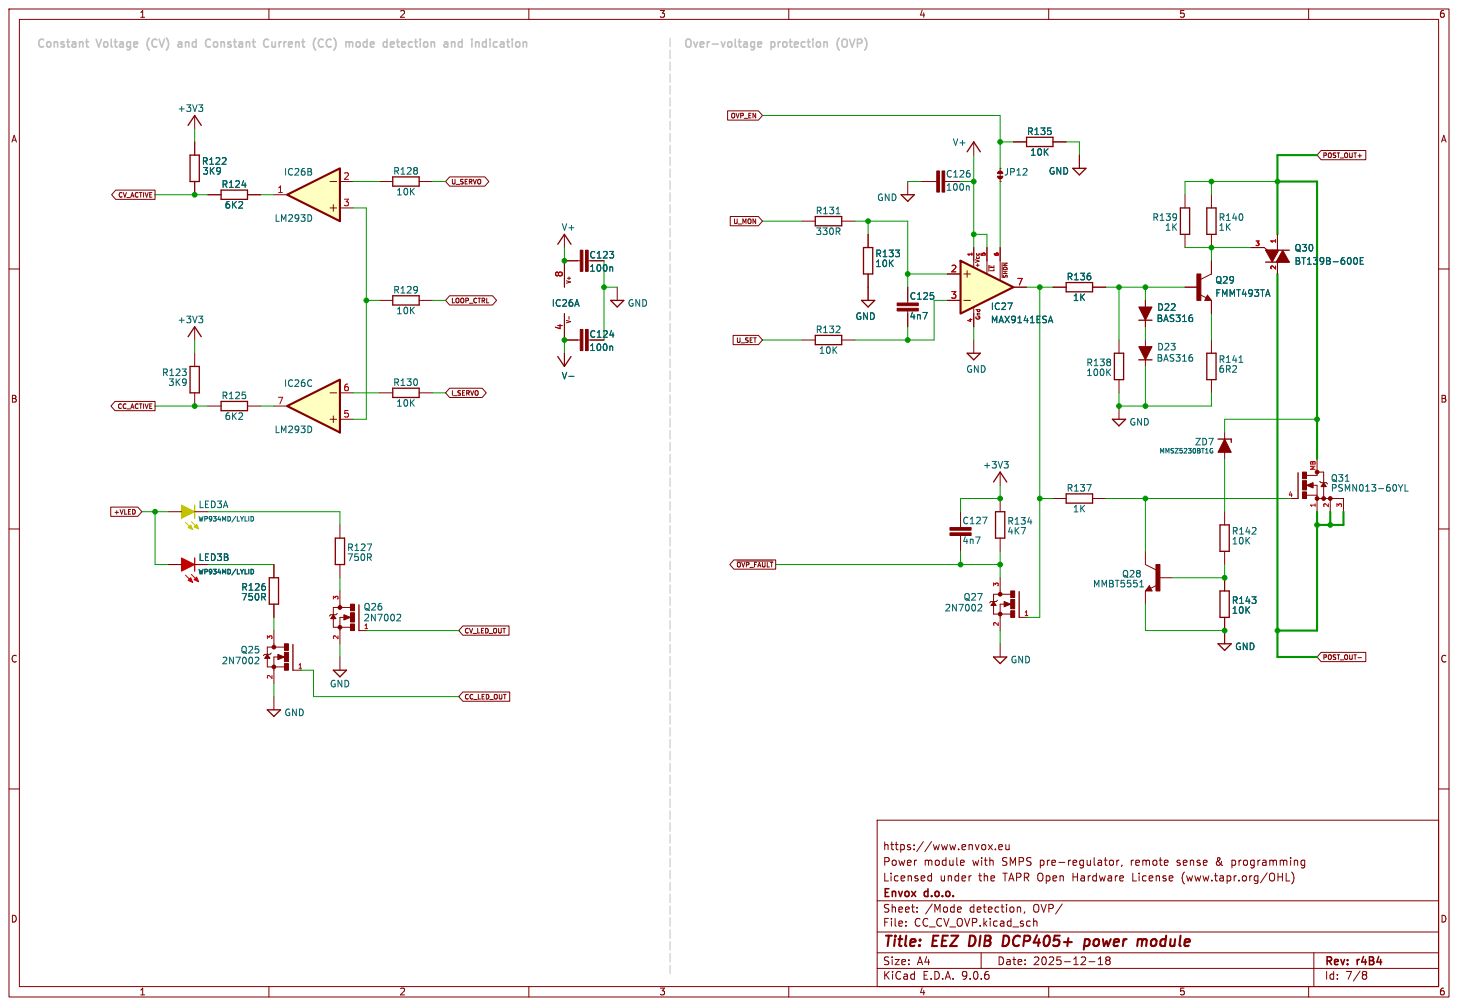
[picture p16: page 8]

https://www.envox.eu
