s070388s/dib-dcp405plus-/fabrication/dxf/EEZ DIB DCP405plus front mask.pdf

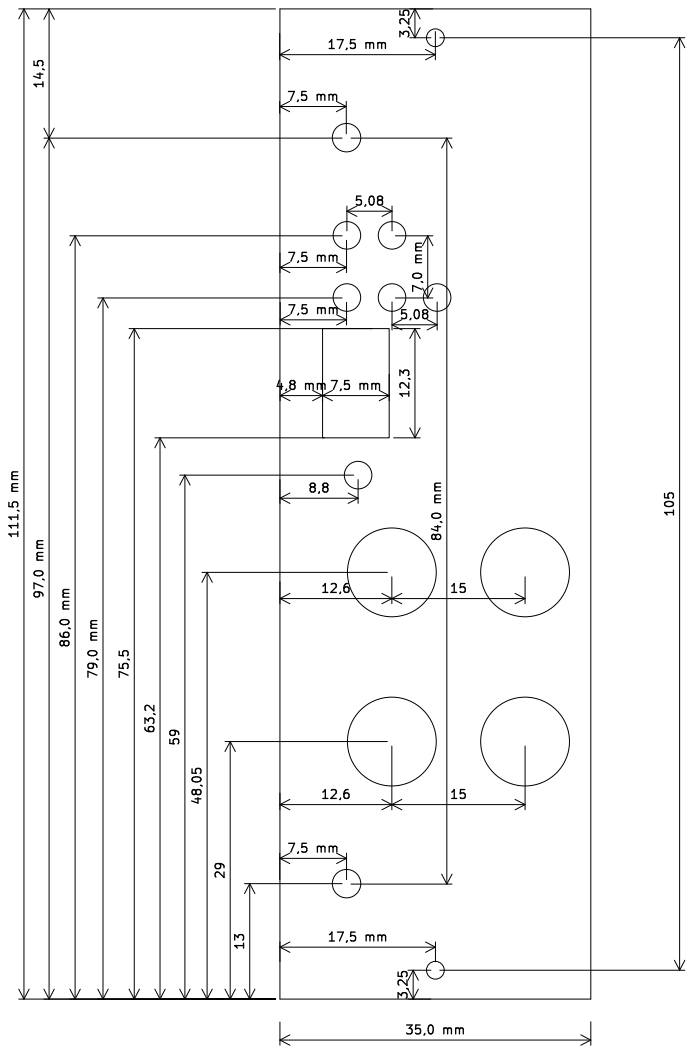
[picture p17: page 1]
