s070388s/dib-dcp405plus-/KiCad/Bias_power.kicad_sch

## KiCad design KiCad/Bias_power.kicad_sch (2025-12-18, an earlier design)

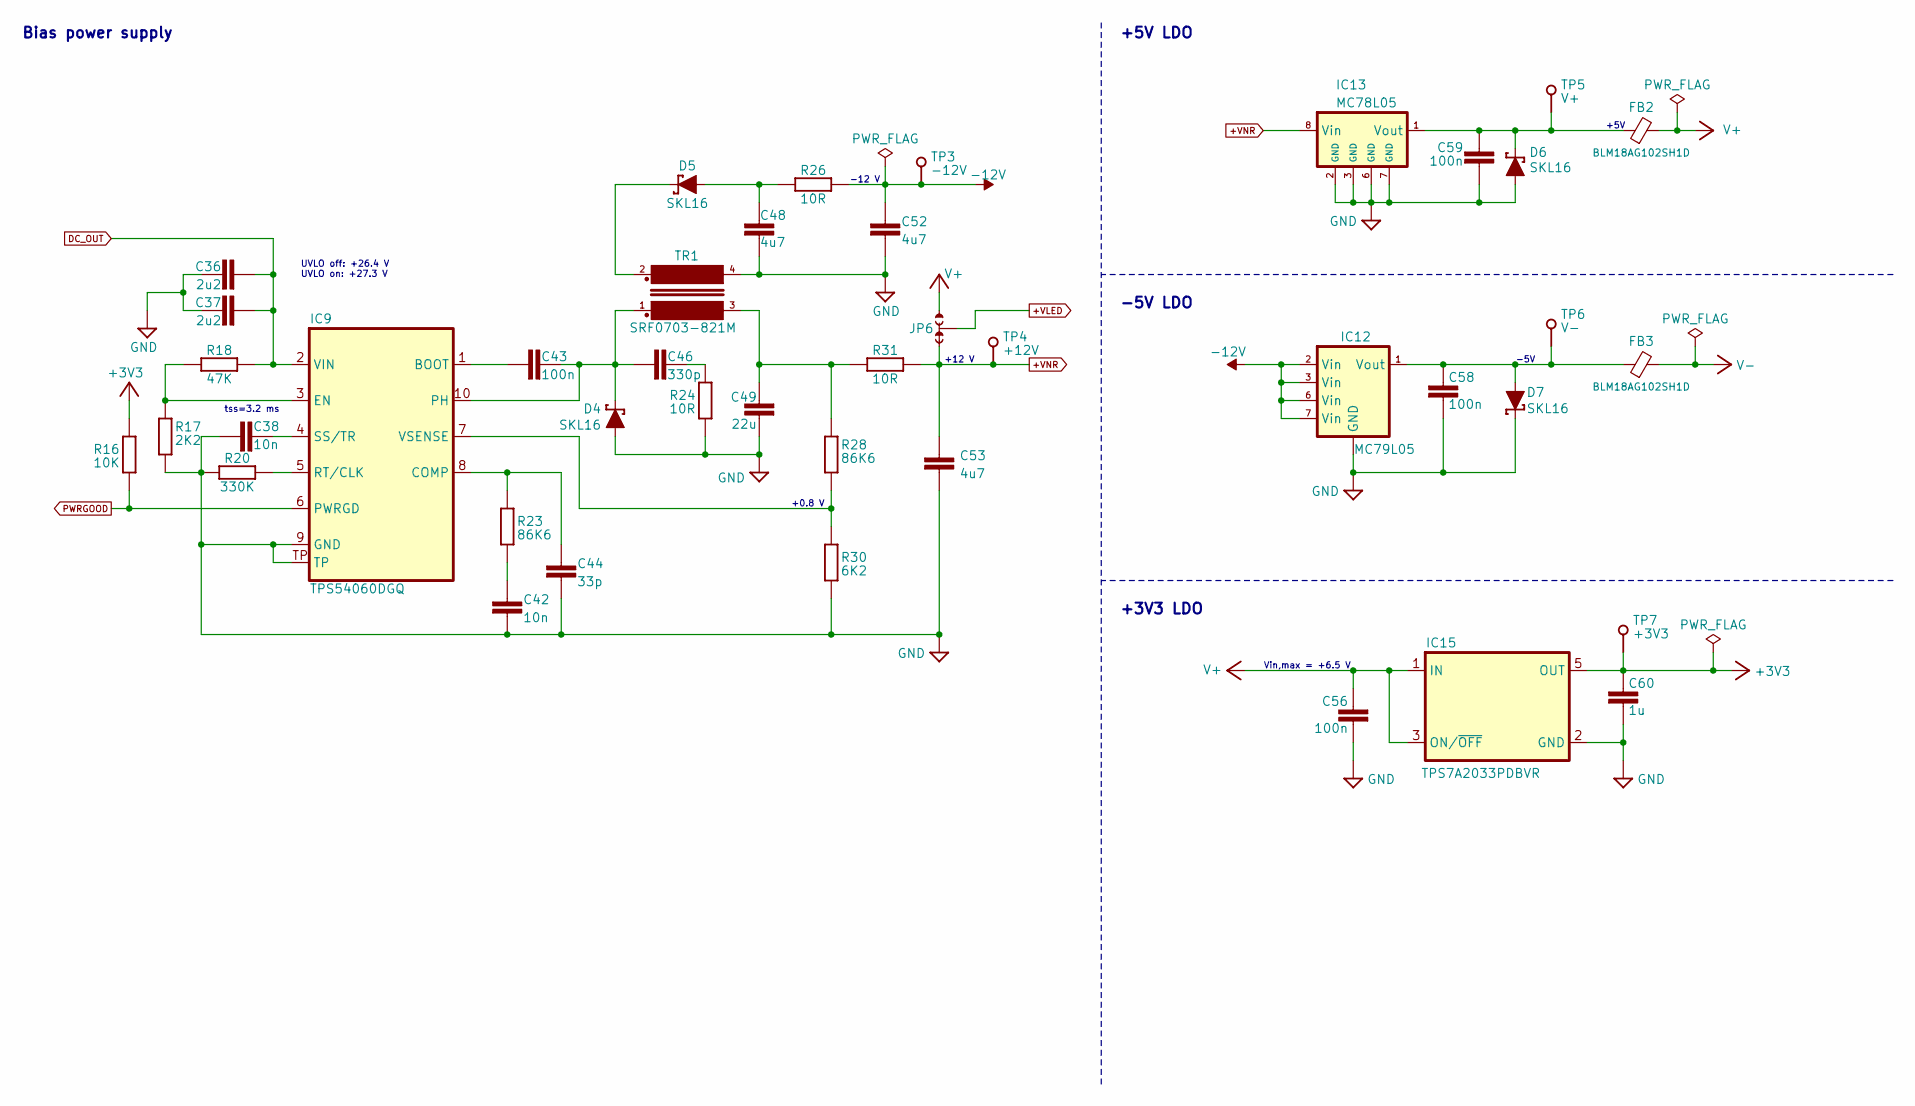
[picture p18: schematic Bias_power.kicad_sch]

Parts:
C36, C37: 2u2; C_1206_3216Metric; DigiKey 1276-3138-1-ND
C38, C42: 10n; C_0805_2012Metric; DigiKey 490-7194-1-ND
C43, C56, C58, C59: 100n; C_0603_1608Metric; DigiKey 490-4774-1-ND
C44: 33p; C_0805_2012Metric; DigiKey 1276-1105-1-ND
C46: 330p; C_0805_2012Metric; DigiKey 1276-1189-1-ND
C48, C52, C53: 4u7; C_1206_3216Metric; DigiKey 1276-2970-1-ND
C49: 22u; C_1210_3225Metric
C60: 1u; C_0805_2012Metric; DigiKey 587-1283-1-ND
D4, D5, D6, D7: SKL16; SOD123; DigiKey RB160MM-60CT-ND
FB2, FB3: BLM18AG102SH1D; BEAD0603; DigiKey 490-7809-1-ND
IC9: TPS54060DGQ; SOP50P490X110-11N; DigiKey 296-37148-1-ND
IC12: MC79L05; SOIC127P600X173-8N; DigiKey MC79L05ABDGOS-ND
IC13: MC78L05; SOIC127P600X173-8N; DigiKey MC78L05ACDR2GOSCT-ND
IC15: TPS7A2033PDBVR; SOT23-5L_STM; DigiKey 296-TPS7A2033PDBVRCT-ND
JP6: JP3 shorted (0603)
R16: 10K; R_0805_2012Metric; DigiKey 311-10.0KCRCT-ND
R17: 2K2; R_0805_2012Metric; DigiKey 311-2.20KCRCT-ND
R18: 47K; R_0805_2012Metric; DigiKey RHM47KKCT-ND
R20: 330K; R_0805_2012Metric; DigiKey A126361CT-ND
R23, R28: 86K6; R_0805_2012Metric; DigiKey 311-86.6KCRCT-ND
R24, R26, R31: 10R; R_0805_2012Metric
R30: 6K2; R_0805_2012Metric
TP3, TP4, TP5, TP6, TP7: TEST-PIN_0.9MM; Testhole 24_50mils
TR1: SRF0703-821M; SRF0703; DigiKey SRF0703-821MCT-ND

Connections:
+3V3: C60.2, IC15.5 (OUT), R16.1, TP7.1
+VLED: JP6.COM
+VNR: C53.1, IC13.8 (Vin), JP6.NC, R31.2, TP4.1
-12V: C52.1, IC12.2 (Vin), IC12.3 (Vin), IC12.6 (Vin), IC12.7 (Vin), R26.2, TP3.1
DC_OUT: C36.1, C37.1, IC9.2 (VIN), R18.2
GND: C36.2, C37.2, C38.2, C42.1, C44.1, C48.2, C49.2, C52.2, C53.2, C56.1, C58.1, C59.2, C60.1, D4.A, D6.A, D7.C, IC9.9 (GND), IC9.TP, IC12.5 (GND), IC13.2 (GND), IC13.3 (GND), IC13.6 (GND), IC13.7 (GND), IC15.2 (GND), R17.1, R20.1, R24.2, R30.2, TR1.4
unnamed: C38.1, IC9.4 (SS/TR)
unnamed: C42.2, R23.1
unnamed: C43.1, C46.1, D4.C, IC9.10 (PH), TR1.1
unnamed: C43.2, IC9.1 (BOOT)
unnamed: C44.2, IC9.8 (COMP), R23.2
unnamed: C46.2, R24.1
unnamed: C48.1, D5.A, R26.1
unnamed: C49.1, R28.1, R31.1, TR1.3
unnamed: C58.2, D7.A, FB3.1, IC12.1 (Vout), TP6.1
unnamed: C59.1, D6.C, FB2.1, IC13.1 (Vout), TP5.1
unnamed: D5.C, TR1.2
unnamed: IC9.3 (EN), R17.2, R18.1
unnamed: IC9.5 (RT/CLK), R20.2
unnamed: IC9.7 (VSENSE), R28.2, R30.1
PWRGOOD: IC9.6 (PWRGD), R16.2
V+: C56.2, FB2.2, IC15.1 (IN), IC15.3 (ON/~OFF), JP6.NO
V-: FB3.2

Notes on the sheet:
+5V
UVLO off: +26.4 V UVLO on: +27.3 V
Vin,max = +6.5 V
+5V LDO
Bias power supply
-5V LDO
+0.8 V
+3V3 LDO
-5V
-12 V
tss=3.2 ms
+12 V
