s070388s/dib-dcp405plus-/KiCad/CC_CV_OVP.kicad_sch

## KiCad design KiCad/CC_CV_OVP.kicad_sch (2025-12-18, an earlier design)

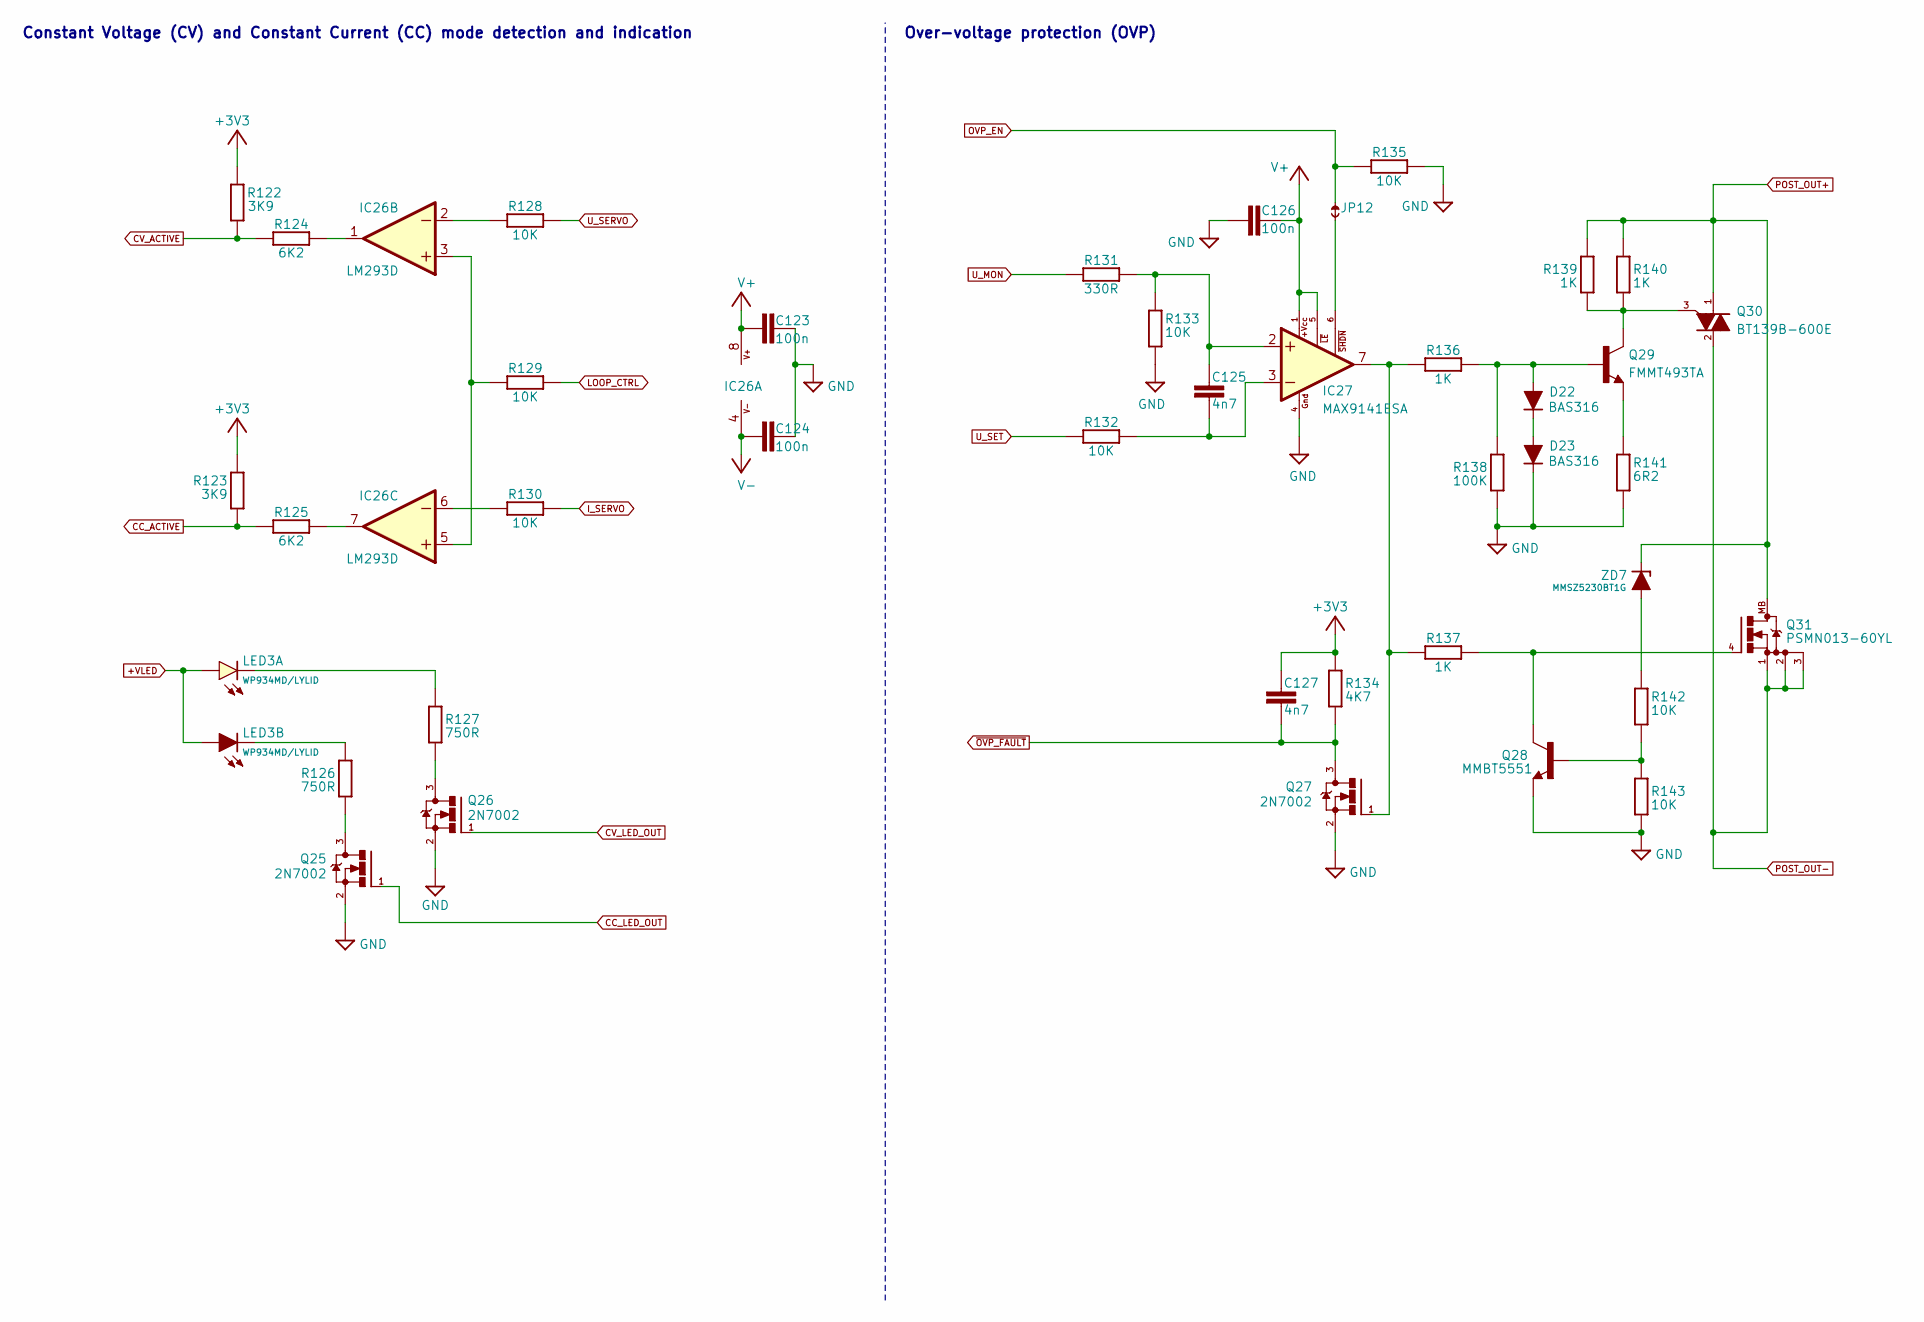
[picture p19: schematic CC_CV_OVP.kicad_sch]

Parts:
C123, C124, C126: 100n; C_0603_1608Metric; DigiKey 490-4774-1-ND
C125, C127: 4n7; C_0805_2012Metric; DigiKey 732-12255-1-ND
D22, D23: BAS316; SOD-323_1P8X1P35_ONS-M; DigiKey 1727-7370-1-ND
IC26: LM293D; SOIC127P600X173-8N; DigiKey LM293DR2GOSCT-ND
IC27: MAX9141ESA; SOIC127P600X173-8N; DigiKey MAX9141ESA+-ND
JP12: JP2-NOCUT-0805; JP2 shorted (0603)
LED3: WP934MD/LYLID; WP934MD_2YD; DigiKey 350-2716-ND
Q25, Q26, Q27: 2N7002; SOT103P240X110-3N; DigiKey T2N7002AKLMCT-ND
Q28: MMBT5551; SOT23-BEC; DigiKey MMBT5551LT1GOSCT-ND
Q29: FMMT493TA; SOT23-BEC; DigiKey FMMT493CT-ND
Q30: BT139B-600E; TO-263_SOT-404; DigiKey 1740-1053-1-ND
Q31: PSMN013-60YL; SOT669; DigiKey 1727-2589-1-ND
R122, R123: 3K9; R_0805_2012Metric; DigiKey A126369CT-ND
R124, R125: 6K2; R_0805_2012Metric
R126, R127: 750R; R_0805_2012Metric; DigiKey A126385CT-ND
R128, R129, R130, R132, R133, R135, R142, R143: 10K; R_0805_2012Metric; DigiKey 311-10.0KCRCT-ND
R131: 330R; R_0805_2012Metric; DigiKey A129743CT-ND
R134: 4K7; R_0805_2012Metric; DigiKey 311-4.70KCRCT-ND
R136, R137, R139, R140: 1K; R_0805_2012Metric; DigiKey RC0805FR-071KL
R138: 100K; R_0805_2012Metric; DigiKey RMCF0805FT100KCT-ND
R141: 6R2; R_0805_2012Metric; DigiKey 311-6.20CRCT-ND
ZD7: MMSZ5230BT1G; SOD123; DigiKey MMSZ5230BT1GOSCT-ND

Connections:
+3V3: C127.1, R122.2, R123.2, R134.1
+VLED: LED3.BA (A), LED3.TA (A)
CC_ACTIVE: R123.1, R125.2
CC_LED_OUT: Q25.1 (G)
CV_ACTIVE: R122.1, R124.2
CV_LED_OUT: Q26.1 (G)
GND: C123.1, C124.1, C126.1, D23.C, IC27.4 (GND), Q25.2 (S), Q26.2 (S), Q27.2 (S), Q28.E, R133.2, R135.1, R138.1, R141.1, R143.1
I_SERVO: R130.1
LOOP_CTRL: R129.2
unnamed: C125.1, IC27.2 (+IN), R131.2, R133.1
unnamed: C125.2, IC27.3 (-IN), R132.2
unnamed: D22.A, Q29.B, R136.1, R138.2
unnamed: D22.C, D23.A
unnamed: IC26.1 (OUT), R124.1
unnamed: IC26.2 (-IN), R128.2
unnamed: IC26.3 (+IN), IC26.5 (+IN), R129.1
unnamed: IC26.6 (-IN), R130.2
unnamed: IC26.7 (OUT), R125.1
unnamed: IC27.6 (~SHDN), JP12.2
unnamed: IC27.7 (OUT), Q27.1 (G), R136.2, R137.2
unnamed: LED3.BC (C), R126.2
unnamed: LED3.TC (C), R127.1
unnamed: Q25.3 (D), R126.1
unnamed: Q26.3 (D), R127.2
unnamed: Q28.B, R142.1, R143.2
unnamed: Q28.C, Q31.4 (G), R137.1
unnamed: Q29.C, Q30.3 (G), R139.1, R140.1
unnamed: Q29.E, R141.2
unnamed: R142.2, ZD7.A
OVP_EN: JP12.1, R135.2
POST_OUT+: Q30.1 (A1), Q31.MB, R139.2, R140.2, ZD7.C
POST_OUT-: Q30.2 (A2), Q31.1 (S), Q31.2 (S), Q31.3 (S)
U_MON: R131.1
U_SERVO: R128.1
U_SET: R132.1
V+: C123.2, C126.2, IC26.8 (V+), IC27.1 (+VCC), IC27.5 (~LE)
V-: C124.2, IC26.4 (V-)
~OVP_FAULT: C127.2, Q27.3 (D), R134.2

Notes on the sheet:
Constant Voltage (CV) and Constant Current (CC) mode detection and indication
Over-voltage protection (OVP)
