s070388s/dib-dcp405plus-/KiCad/DAC_Vref_IOEXP_Temp.kicad_sch

## KiCad design KiCad/DAC_Vref_IOEXP_Temp.kicad_sch (2025-12-18, an earlier design)

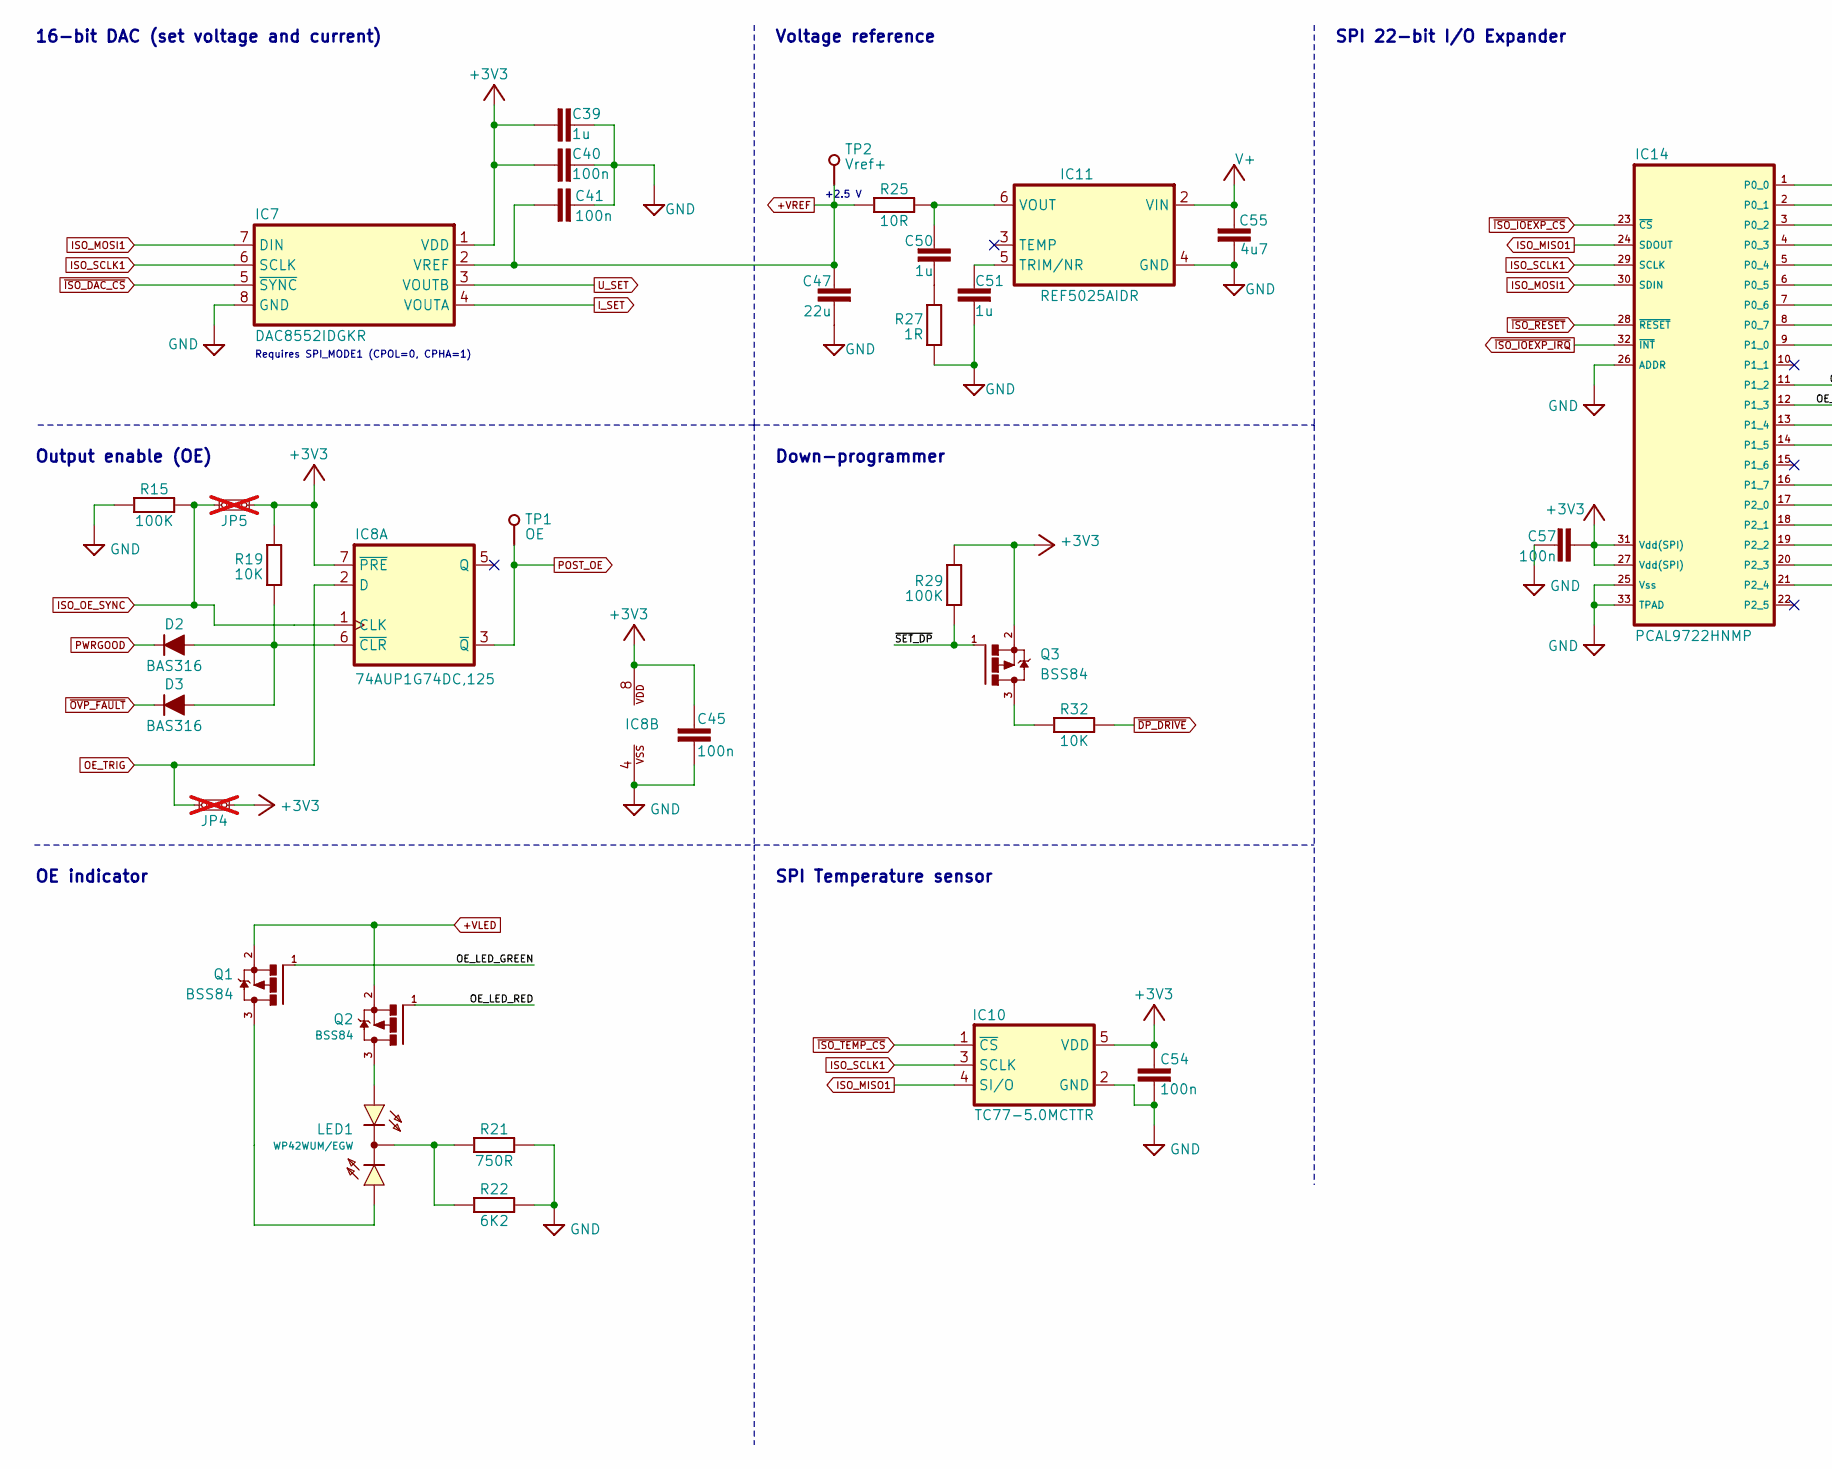
[picture p20: schematic DAC_Vref_IOEXP_Temp.kicad_sch, part in row 1, column 1]

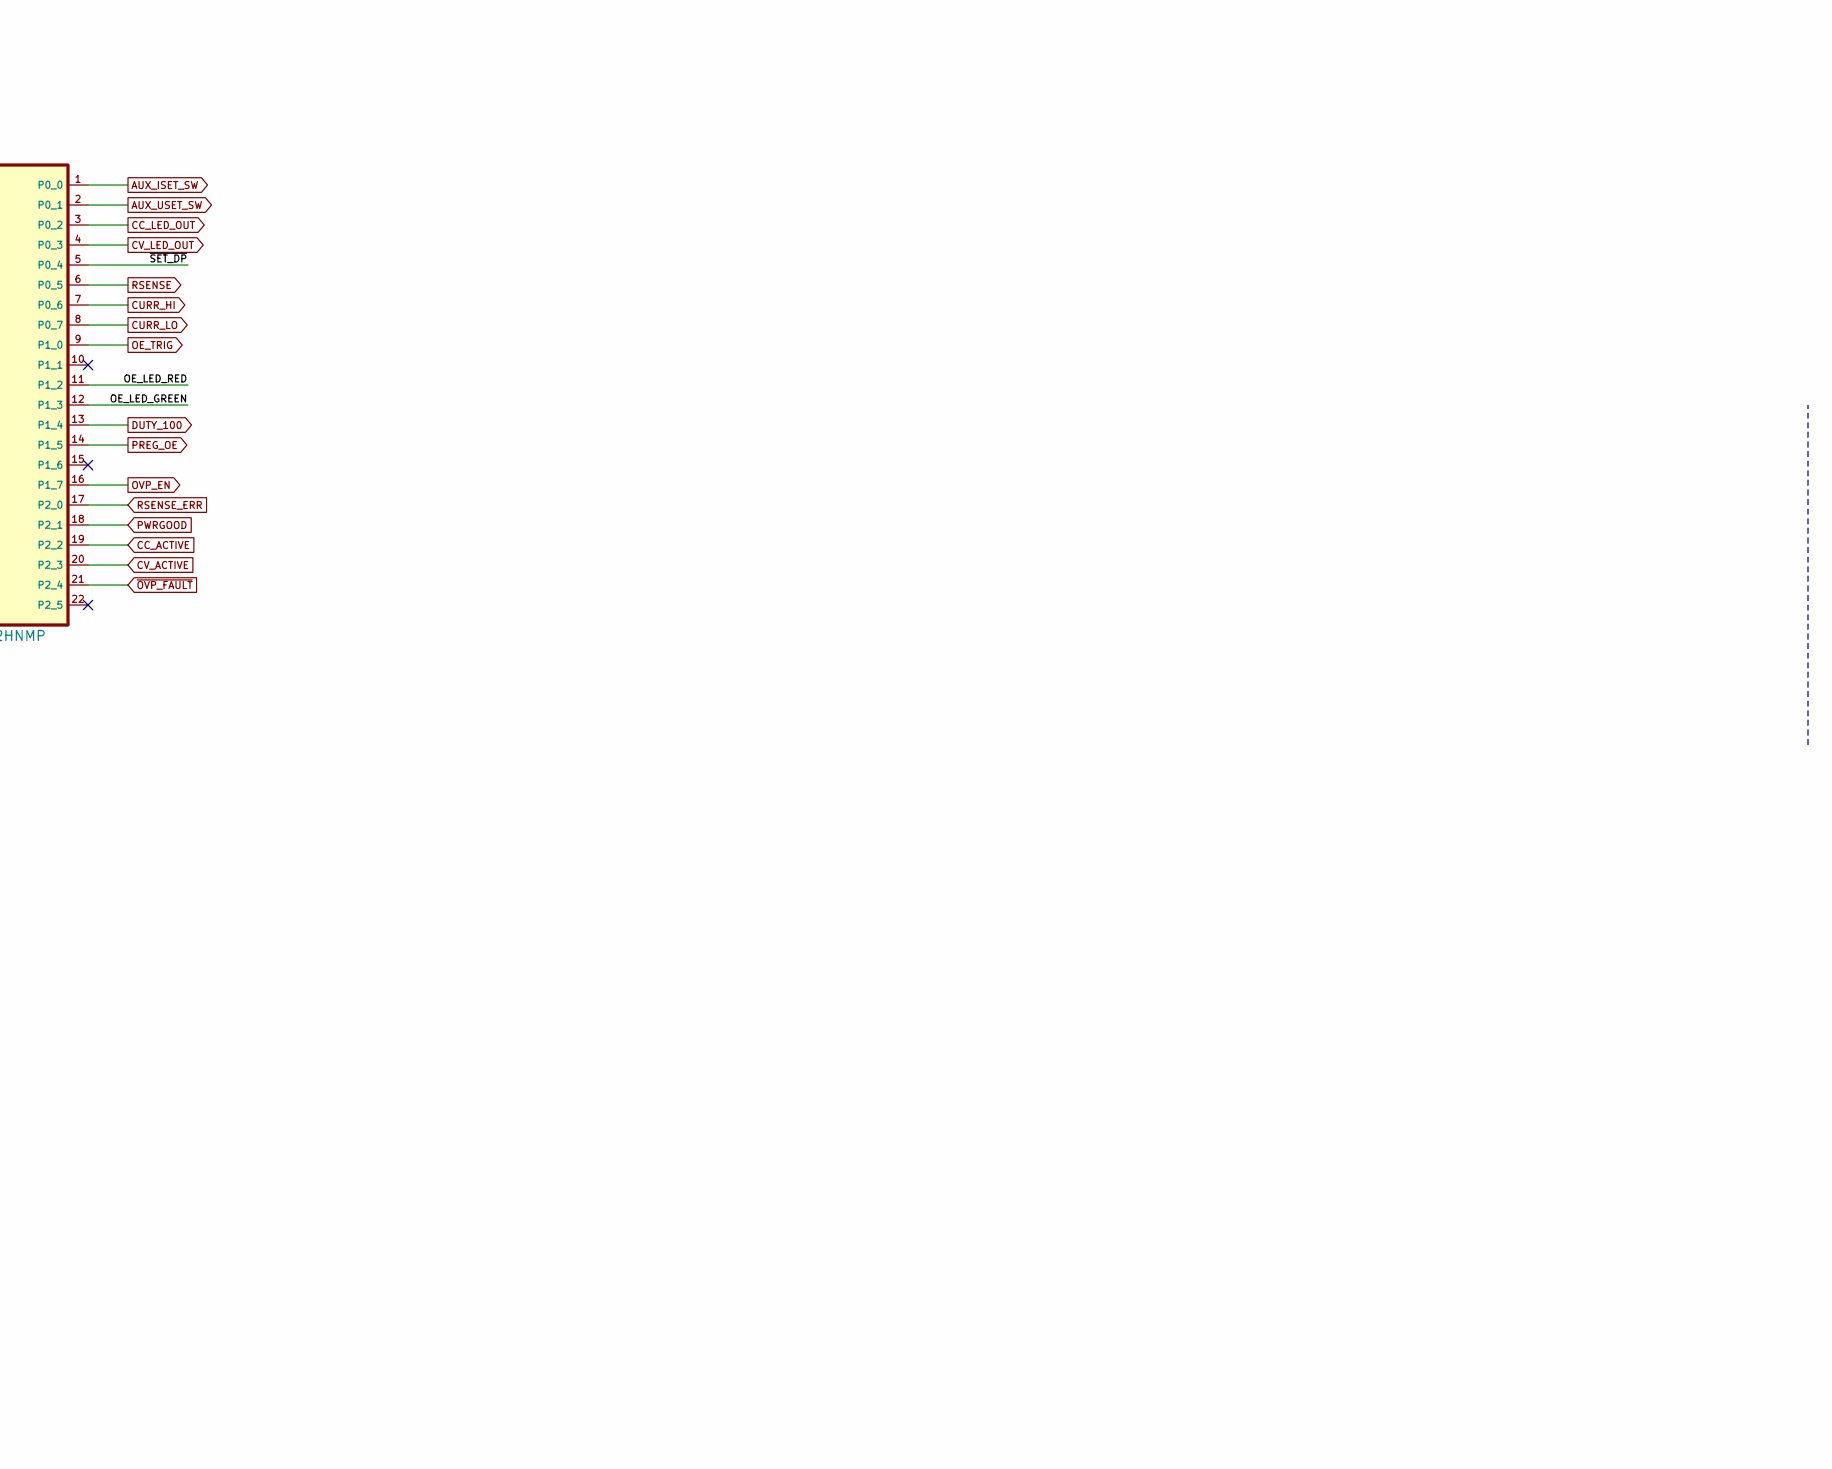
[picture p21: schematic DAC_Vref_IOEXP_Temp.kicad_sch, part in row 1, column 2]

Parts:
C39, C50, C51: 1u; C_0805_2012Metric; DigiKey 587-1283-1-ND
C40, C41, C45, C54, C57: 100n; C_0603_1608Metric; DigiKey 490-4774-1-ND
C47: 22u; C_1210_3225Metric
C55: 4u7; C_1206_3216Metric; DigiKey 1276-2970-1-ND
D2, D3: BAS316; SOD-323_1P8X1P35_ONS-M; DigiKey 1727-7370-1-ND
IC7: DAC8552IDGKR; DGK8-M; DigiKey 296-46082-1-ND
IC8: 74AUP1G74DC,125; DCU8; DigiKey 1727-6029-2-ND
IC10: TC77-5.0MCTTR; SOT23-5L_STM; DigiKey TC77-5.0MCTTRCT-ND
IC11: REF5025AIDR; SOIC127P600X173-8N; DigiKey 296-39165-1-ND
IC14: PCAL9722HNMP; HVQFN32_SOT617-1_NXP-M; DigiKey 568-PCAL9722HNMPTR-ND
JP4, JP5: M22-2010246; DigiKey M22-2010346-ND; not fitted
LED1: WP42WUM/EGW; L-42WUM-1EGWT; DigiKey 754-1718-ND
Q1, Q2, Q3: BSS84; SOT103P240X110-3N; DigiKey BSS84LT1GOSCT-ND
R15, R29: 100K; R_0805_2012Metric; DigiKey RMCF0805FT100KCT-ND
R19, R32: 10K; R_0805_2012Metric; DigiKey 311-10.0KCRCT-ND
R21: 750R; R_0805_2012Metric; DigiKey A126385CT-ND
R22: 6K2; R_0805_2012Metric
R25: 10R; R_0805_2012Metric
R27: 1R; R_0805_2012Metric
TP1: TEST-PIN_0.9MM; Testhole 24_50mils
TP2: PCB_TEST_TABSHIELD; Testhole 24_50mils

Connections:
+3V3: C39.1, C40.2, C45.2, C54.1, C57.2, IC7.1 (VDD), IC8.7 (~PRE), IC8.8 (VDD), IC10.5 (VDD), IC14.27 (Vdd(SPI)), IC14.31 (Vdd(SPI)), JP4.1, JP5.1, Q3.2 (S), R19.2, R29.1
+VLED: Q1.2 (S), Q2.2 (S)
+VREF: C41.2, C47.1, IC7.2 (VREF), R25.1, TP2.1
AUX_ISET_SW: IC14.1 (P0_0)
AUX_USET_SW: IC14.2 (P0_1)
CC_ACTIVE: IC14.19 (P2_2)
CC_LED_OUT: IC14.3 (P0_2)
CURR_HI: IC14.7 (P0_6)
CURR_LO: IC14.8 (P0_7)
CV_ACTIVE: IC14.20 (P2_3)
CV_LED_OUT: IC14.4 (P0_3)
DUTY_100: IC14.13 (P1_4)
GND: C39.2, C40.1, C41.1, C45.1, C47.2, C51.2, C54.2, C55.2, C57.1, IC7.8 (GND), IC8.4 (VSS), IC10.2 (GND), IC11.4 (GND), IC14.25 (Vss), IC14.26 (ADDR), IC14.33 (TPAD), R15.1, R21.2, R22.2, R27.2
ISO_MISO1: IC10.4 (SI/O), IC14.24 (SDOUT)
ISO_MOSI1: IC7.7 (DIN), IC14.30 (SDIN)
ISO_OE_SYNC: IC8.1 (CLK), JP5.2, R15.2
ISO_SCLK1: IC7.6 (SCLK), IC10.3 (SCLK), IC14.29 (SCLK)
I_SET: IC7.4 (VOUTA)
unnamed: C50.1, IC11.6 (VOUT), R25.2
unnamed: C50.2, R27.1
unnamed: C51.1, IC11.5 (TRIM/NR)
unnamed: D2.A, D3.A, IC8.6 (~CLR), R19.1
unnamed: LED1.CC (C), R21.1, R22.1
unnamed: LED1.GREEN (AG), Q1.3 (D)
unnamed: LED1.RED (AR), Q2.3 (D)
unnamed: Q3.3 (D), R32.2
OE_LED_GREEN: IC14.12 (P1_3), Q1.1 (G)
OE_LED_RED: IC14.11 (P1_2), Q2.1 (G)
OE_TRIG: IC8.2 (D), IC14.9 (P1_0), JP4.2
OVP_EN: IC14.16 (P1_7)
POST_OE: IC8.3 (~Q), TP1.1
PREG_OE: IC14.14 (P1_5)
PWRGOOD: D2.C, IC14.18 (P2_1)
RSENSE: IC14.6 (P0_5)
RSENSE_ERR: IC14.17 (P2_0)
U_SET: IC7.3 (VOUTB)
V+: C55.1, IC11.2 (VIN)
~DP_DRIVE: R32.1
~ISO_DAC_CS: IC7.5 (~SYNC)
~ISO_IOEXP_CS: IC14.23 (~CS)
~ISO_IOEXP_IRQ: IC14.32 (~INT)
~ISO_RESET: IC14.28 (~RESET)
~ISO_TEMP_CS: IC10.1 (~CS)
~OVP_FAULT: D3.C, IC14.21 (P2_4)
~SET_DP: IC14.5 (P0_4), Q3.1 (G), R29.2

Notes on the sheet:
Voltage reference
Down-programmer
Requires SPI_MODE1 (CPOL=0, CPHA=1)
Output enable (OE)
16-bit DAC (set voltage and current)
+2.5 V
SPI Temperature sensor
OE indicator
SPI 22-bit I/O Expander
