s070388s/dib-dcp405plus-/KiCad/DIB_EEPROM_ADC_MCU.kicad_sch

## KiCad design KiCad/DIB_EEPROM_ADC_MCU.kicad_sch (2025-12-18, an earlier design)

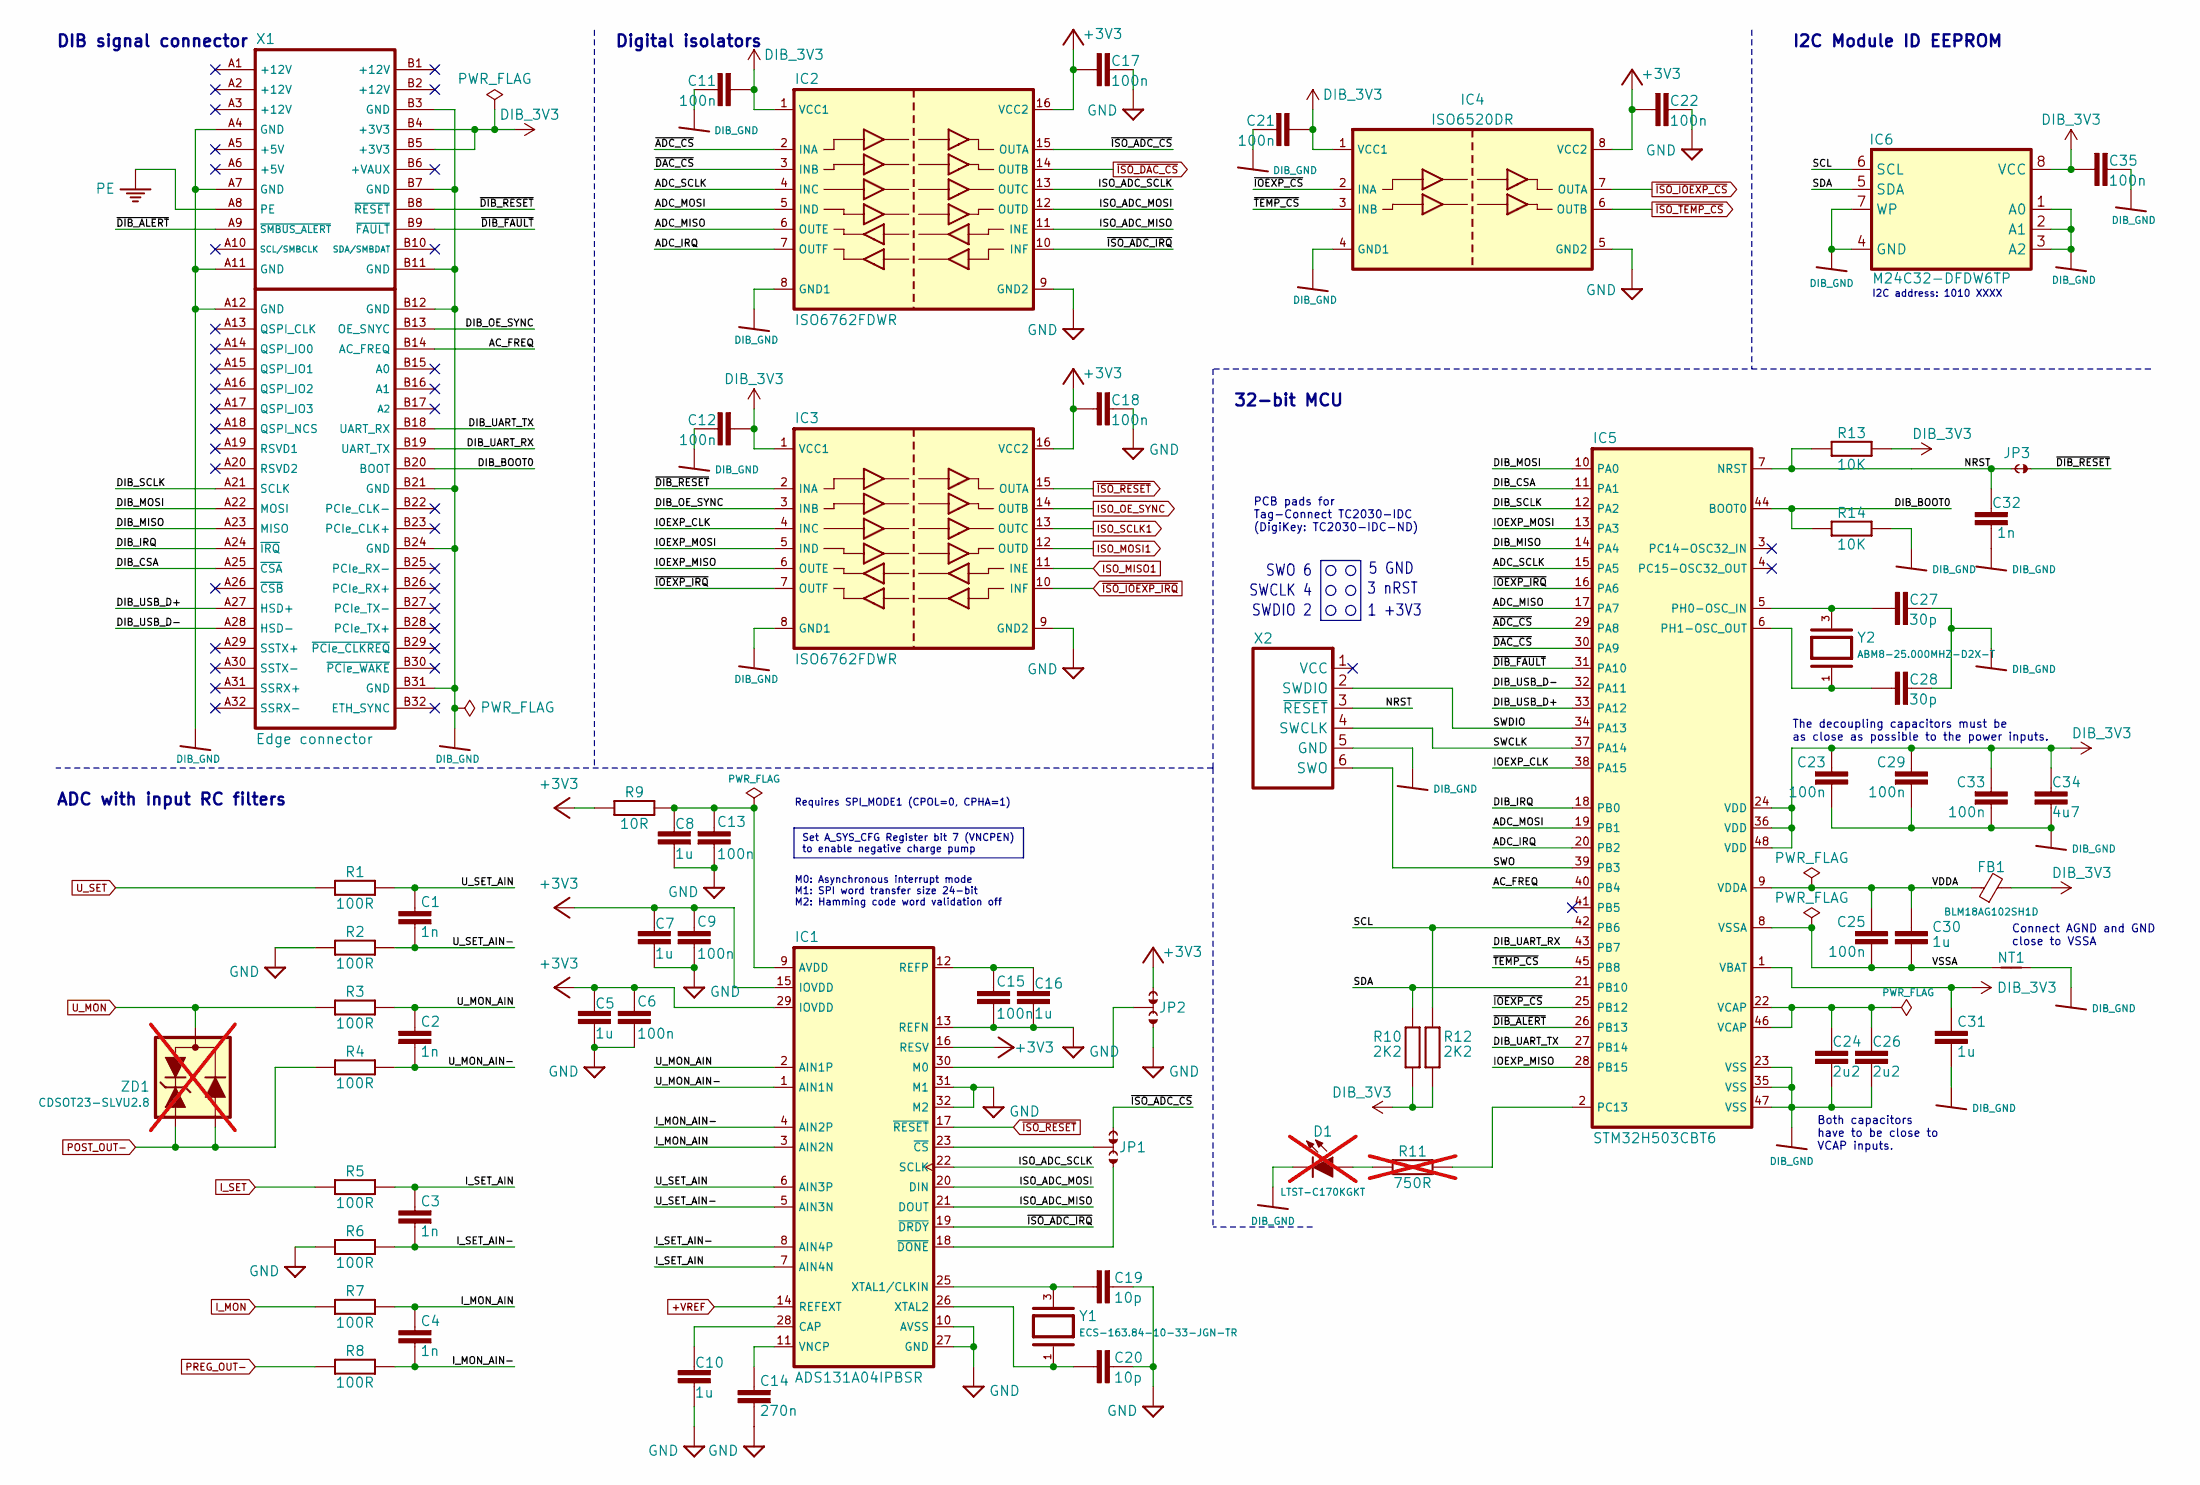
[picture p22: schematic DIB_EEPROM_ADC_MCU.kicad_sch]

Parts:
C1, C2, C3, C4, C32: 1n; C_0603_1608Metric; DigiKey 732-7858-1-ND
C5, C7, C8, C10, C16, C30, C31: 1u; C_0805_2012Metric; DigiKey 587-1283-1-ND
C6, C9, C11, C12, C13, C15, C17, C18, C21, C22, C23, C25, C29, C33, C35: 100n; C_0603_1608Metric; DigiKey 490-4774-1-ND
C14: 270n; C_0603_1608Metric
C19, C20: 10p; C_0603_1608Metric; DigiKey 1276-1069-1-ND
C24, C26: 2u2; C_1206_3216Metric; DigiKey 1276-3138-1-ND
C27, C28: 30p; C_0603_1608Metric; DigiKey 1292-1515-1-ND
C34: 4u7; C_1206_3216Metric; DigiKey 1276-2970-1-ND
D1: LTST-C170KGKT; LED_LTST-C170KGKT_LTO-L; DigiKey 160-1414-2-ND; not fitted
FB1: BLM18AG102SH1D; BEAD0603; DigiKey 490-7809-1-ND
IC1: ADS131A04IPBSR; QFP50P700X700X120-32N; DigiKey 296-44202-1-ND
IC2, IC3: ISO6762FDWR; DW16; DigiKey 296-ISO6762FDWRCT-ND
IC4: ISO6520DR; SOIC127P600X173-8N; DigiKey 296-ISO6520DRCT-ND
IC5: STM32H503CBT6; LQFP-48_7X7MM; DigiKey 497-STM32H503CBT6-ND
IC6: M24C32-DFDW6TP; TSSOP-8; DigiKey 497-16067-1-ND
JP1, JP2: 0R; JP3 shorted (0603)
JP3: JP2 shorted (0603)
NT1: NetTie_2; NetTie-2_SMD_Pad0.2mm
R1, R2, R3, R4, R5, R6, R7, R8: 100R; R_0603_1608Metric; DigiKey 13-RC0603FR-10100RLCT-ND
R9: 10R; R_0805_2012Metric
R10, R12: 2K2; R_0805_2012Metric; DigiKey 311-2.20KCRCT-ND
R11: 750R; R_0805_2012Metric; DigiKey A126385CT-ND; not fitted
R13, R14: 10K; R_0805_2012Metric; DigiKey 311-10.0KCRCT-ND
X1: Edge connector; DIB 2.0 edge card connector; DigiKey 609-1969-ND
X2: N.C.; TC2030
Y1: ECS-163.84-10-33-JGN-TR; XTAL_403C11A24M00000; DigiKey 535-14398-1-ND
Y2: ABM8-25.000MHZ-D2X-T; XTAL_403C11A24M00000; DigiKey 535-14398-1-ND
ZD1: CDSOT23-SLVU2.8; SOT23-3; DigiKey CDSOT23-SLVU2.8TR-ND; not fitted

Connections:
+3V3: C5.1, C6.2, C7.1, C9.2, C17.2, C18.2, C22.2, IC1.15 (IOVDD), IC1.16 (RESV), IC1.29 (IOVDD), IC2.16 (VCC2), IC3.16 (VCC2), IC4.8 (VCC2), JP2.NC, R9.1
+VREF: IC1.14 (REFEXT)
AC_FREQ: IC5.40 (PB4), X1.B14 (AC_FREQ)
ADC_IRQ: IC2.7 (OUTF), IC5.20 (PB2)
ADC_MISO: IC2.6 (OUTE), IC5.17 (PA7)
ADC_MOSI: IC2.5 (IND), IC5.19 (PB1)
ADC_SCLK: IC2.4 (INC), IC5.15 (PA5)
DIB_3V3: C11.2, C12.2, C21.2, C23.1, C29.1, C31.2, C33.1, C34.1, C35.2, FB1.2, IC2.1 (VCC1), IC3.1 (VCC1), IC4.1 (VCC1), IC5.1 (VBAT), IC5.24 (VDD), IC5.36 (VDD), IC5.48 (VDD), IC6.8 (VCC), R10.1, R12.1, R13.2, X1.B4 (+3V3), X1.B5 (+3V3)
DIB_BOOT0: IC5.44 (BOOT0), R14.2, X1.B20 (BOOT)
DIB_CSA: IC5.11 (PA1), X1.A25 (~CSA)
DIB_GND: C11.1, C12.1, C21.1, C23.2, C24.1, C26.1, C27.1, C28.1, C29.2, C31.1, C32.1, C33.2, C34.2, C35.1, D1.C, IC2.8 (GND1), IC3.8 (GND1), IC4.4 (GND1), IC5.23 (VSS), IC5.35 (VSS), IC5.47 (VSS), IC6.1 (A0), IC6.2 (A1), IC6.3 (A2), IC6.4 (GND), IC6.7 (WP), NT1.2, R14.1, X1.A4 (GND), X1.A7 (GND), X1.A11 (GND), X1.A12 (GND), X1.B3 (GND), X1.B7 (GND), X1.B11 (GND), X1.B12 (GND), X1.B21 (GND), X1.B24 (GND), X1.B31 (GND), X2.5 (GND)
DIB_IRQ: IC5.18 (PB0), X1.A24 (~IRQ)
DIB_MISO: IC5.14 (PA4), X1.A23 (MISO)
DIB_MOSI: IC5.10 (PA0), X1.A22 (MOSI)
DIB_OE_SYNC: IC3.3 (INB), X1.B13 (OE_SNYC)
DIB_SCLK: IC5.12 (PA2), X1.A21 (SCLK)
DIB_UART_RX: IC5.43 (PB7), X1.B19 (UART_TX)
DIB_UART_TX: IC5.27 (PB14), X1.B18 (UART_RX)
DIB_USB_D+: IC5.33 (PA12), X1.A27 (HSD+)
DIB_USB_D-: IC5.32 (PA11), X1.A28 (HSD-)
GND: C5.2, C6.1, C7.2, C8.2, C9.1, C10.2, C13.1, C14.1, C15.1, C16.2, C17.1, C18.1, C19.1, C20.1, C22.1, IC1.10 (AVSS), IC1.13 (REFN), IC1.27 (GND), IC1.31 (M1), IC1.32 (M2), IC2.9 (GND2), IC3.9 (GND2), IC4.5 (GND2), JP2.NO, R2.2, R6.2
IOEXP_CLK: IC3.4 (INC), IC5.38 (PA15)
IOEXP_MISO: IC3.6 (OUTE), IC5.28 (PB15)
IOEXP_MOSI: IC3.5 (IND), IC5.13 (PA3)
ISO_ADC_MISO: IC1.21 (DOUT), IC2.11 (INE)
ISO_ADC_MOSI: IC1.20 (DIN), IC2.12 (OUTD)
ISO_ADC_SCLK: IC1.22 (SCLK), IC2.13 (OUTC)
ISO_MISO1: IC3.11 (INE)
ISO_MOSI1: IC3.12 (OUTD)
ISO_OE_SYNC: IC3.14 (OUTB)
ISO_SCLK1: IC3.13 (OUTC)
I_MON: R7.2
I_MON_AIN: C4.2, IC1.3 (AIN2N), R7.1
I_MON_AIN-: C4.1, IC1.4 (AIN2P), R8.1
I_SET: R5.2
I_SET_AIN: C3.2, IC1.7 (AIN4N), R5.1
I_SET_AIN-: C3.1, IC1.8 (AIN4P), R6.1
NRST: C32.2, IC5.7 (NRST), JP3.2, R13.1, X2.3 (~RESET)
unnamed: C10.1, IC1.28 (CAP)
unnamed: C8.1, C13.2, IC1.9 (AVDD), R9.2
unnamed: C14.2, IC1.11 (VNCP)
unnamed: C15.2, C16.1, IC1.12 (REFP)
unnamed: C19.2, IC1.25 (XTAL1/CLKIN), Y1.3
unnamed: C20.2, IC1.26 (XTAL2), Y1.1
unnamed: C24.2, C26.2, IC5.22 (VCAP), IC5.46 (VCAP)
unnamed: C27.2, IC5.5 (PH0-OSC_IN), Y2.3
unnamed: C28.2, IC5.6 (PH1-OSC_OUT), Y2.1
unnamed: D1.A, R11.1
unnamed: IC1.18 (~DONE), JP1.NO
unnamed: IC1.23 (~CS), JP1.COM
unnamed: IC1.30 (M0), JP2.COM
unnamed: IC5.2 (PC13), R11.2
PE: X1.A8 (PE)
POST_OUT-: R4.2, ZD1.1, ZD1.2
PREG_OUT-: R8.2
SCL: IC5.42 (PB6), IC6.6 (SCL), R12.2
SDA: IC5.21 (PB10), IC6.5 (SDA), R10.2
SWCLK: IC5.37 (PA14), X2.4 (SWCLK)
SWDIO: IC5.34 (PA13), X2.2 (SWDIO)
SWO: IC5.39 (PB3), X2.6 (SWO)
U_MON: R3.2, ZD1.3
U_MON_AIN: C2.1, IC1.2 (AIN1P), R3.1
U_MON_AIN-: C2.2, IC1.1 (AIN1N), R4.1
U_SET: R1.2
U_SET_AIN: C1.2, IC1.6 (AIN3P), R1.1
U_SET_AIN-: C1.1, IC1.5 (AIN3N), R2.1
VDDA: C25.1, C30.2, FB1.1, IC5.9 (VDDA)
VSSA: C25.2, C30.1, IC5.8 (VSSA), NT1.1
~ADC_CS: IC2.2 (INA), IC5.29 (PA8)
~DAC_CS: IC2.3 (INB), IC5.30 (PA9)
~DIB_ALERT: IC5.26 (PB13), X1.A9 (~SMBUS_ALERT)
~DIB_FAULT: IC5.31 (PA10), X1.B9 (~FAULT)
~DIB_RESET: IC3.2 (INA), JP3.1, X1.B8 (~RESET)
~IOEXP_CS: IC4.2 (INA), IC5.25 (PB12)
~IOEXP_IRQ: IC3.7 (OUTF), IC5.16 (PA6)
~ISO_ADC_CS: IC2.15 (OUTA), JP1.NC
~ISO_ADC_IRQ: IC1.19 (~DRDY), IC2.10 (INF)
~ISO_DAC_CS: IC2.14 (OUTB)
~ISO_IOEXP_CS: IC4.7 (OUTA)
~ISO_IOEXP_IRQ: IC3.10 (INF)
~ISO_RESET: IC1.17 (~RESET), IC3.15 (OUTA)
~ISO_TEMP_CS: IC4.6 (OUTB)
~TEMP_CS: IC4.3 (INB), IC5.45 (PB8)

Notes on the sheet:
Digital isolators
Requires SPI_MODE1 (CPOL=0, CPHA=1)
DIB signal connector
3 nRST
SWCLK 4
32-bit MCU
The decoupling capacitors must be as close as possible to the power inputs.
1 +3V3
SWO 6
ADC with input RC filters
I2C address: 1010 XXXX
PCB pads for Tag-Connect TC2030-IDC (DigiKey: TC2030-IDC-ND)
SWDIO 2
5 GND
Connect AGND and GND close to VSSA
M0: Asynchronous interrupt mode M1: SPI word transfer size 24-bit M2: Hamming code word validation off
I2C Module ID EEPROM
Both capacitors have to be close to VCAP inputs.
Set A_SYS_CFG Register bit 7 (VNCPEN) to enable negative charge pump
