s070388s/dib-dcp405plus-/KiCad/EEZ DIB DCP405plus.kicad_sch

## KiCad design KiCad/EEZ DIB DCP405plus.kicad_sch (2025-12-18, an earlier design)

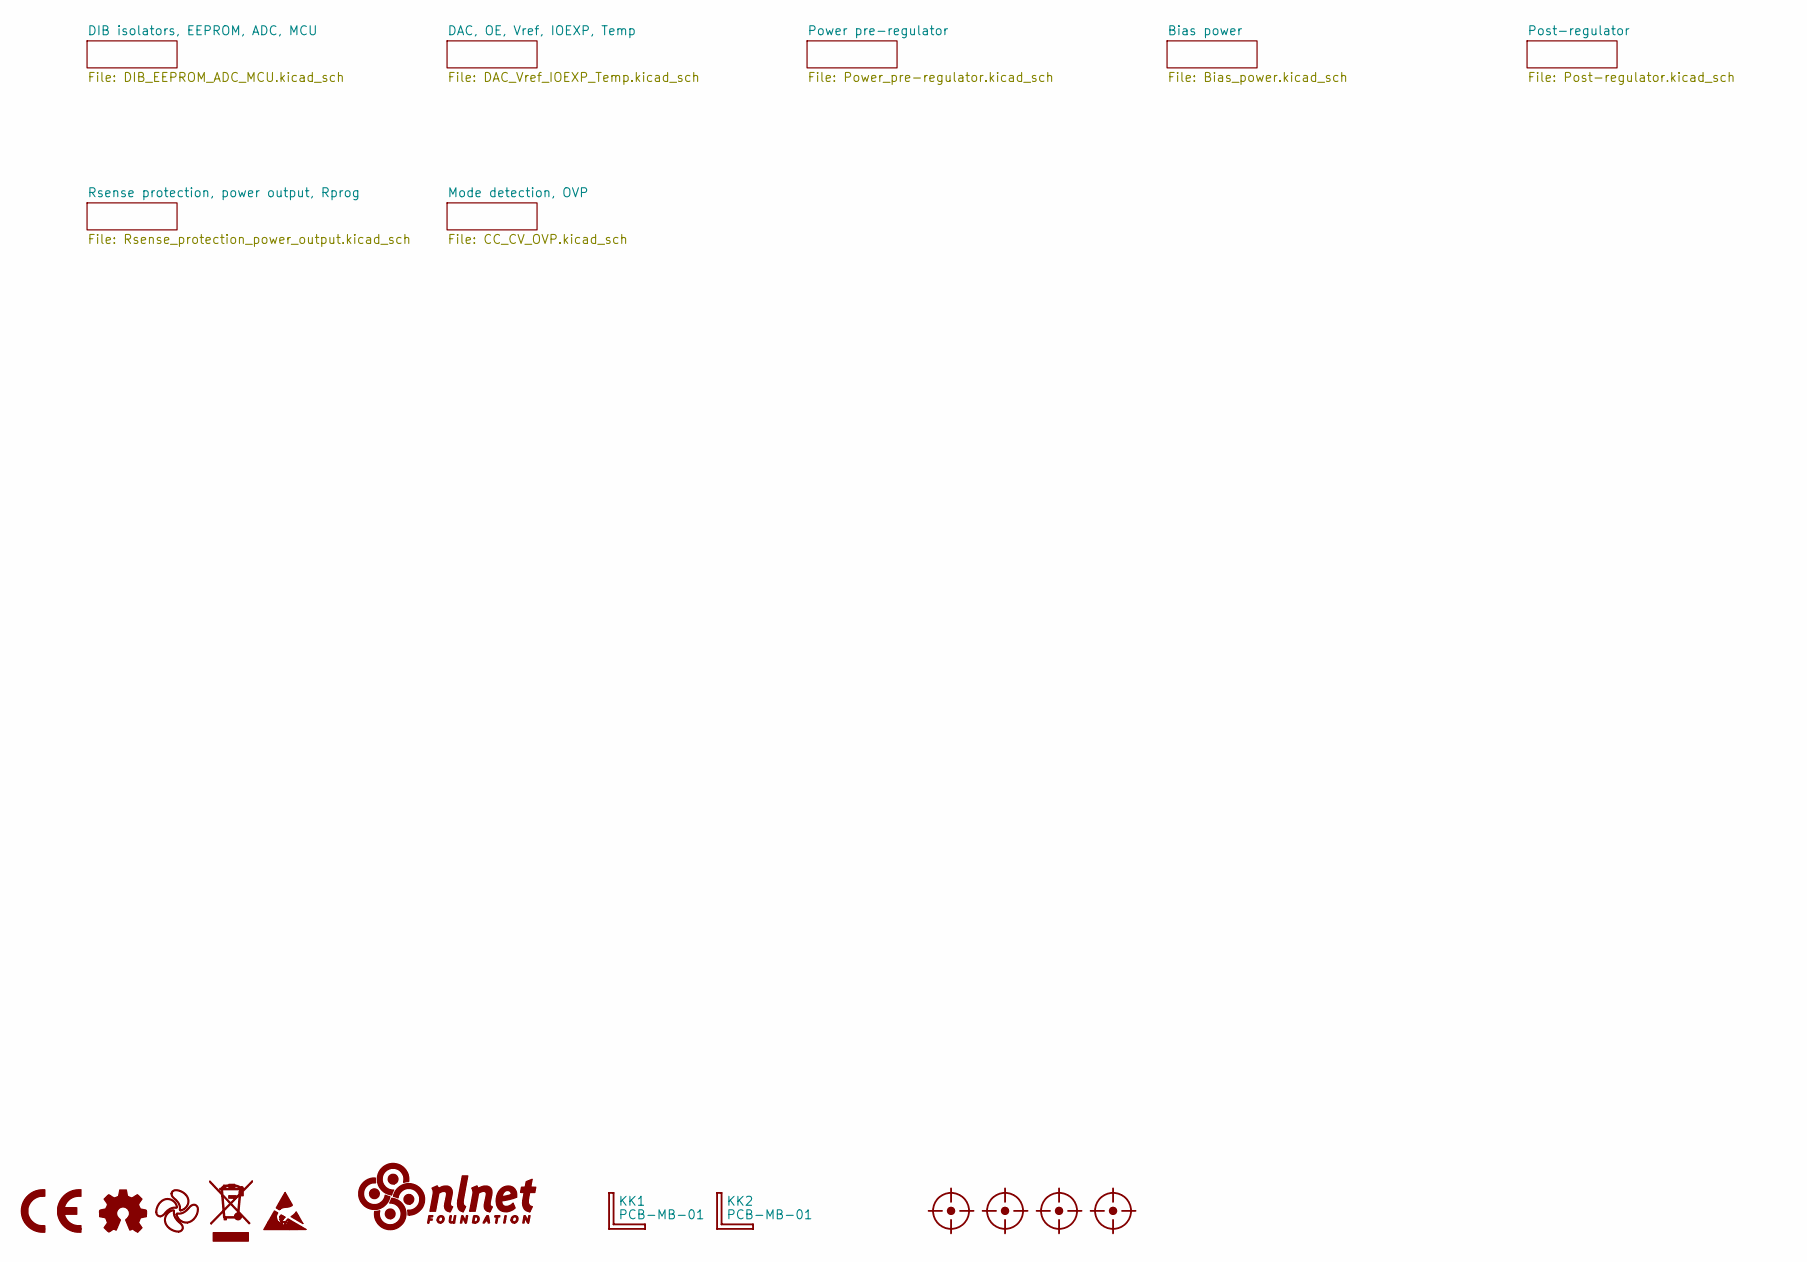
[picture p23: schematic EEZ DIB DCP405plus.kicad_sch]

Parts:
FM1, FM2, FM3, FM4: FIDUCIAL; Fiducial_0.75mm_Mask1.5mm
KK1, KK2: PCB-MB-01; DigiKey RPC1760-ND
LOGO1: CR logo; CE logo
LOGO2: Open HW logo
LOGO3: EEZ logo; EEZ logo (outline 6mm)
LOGO4: WEEE logo
LOGO5: ESD logo
LOGO6: NLnet logo
