s070388s/dib-dcp405plus-/KiCad/Post-regulator.kicad_sch

## KiCad design KiCad/Post-regulator.kicad_sch (2025-12-18, an earlier design)

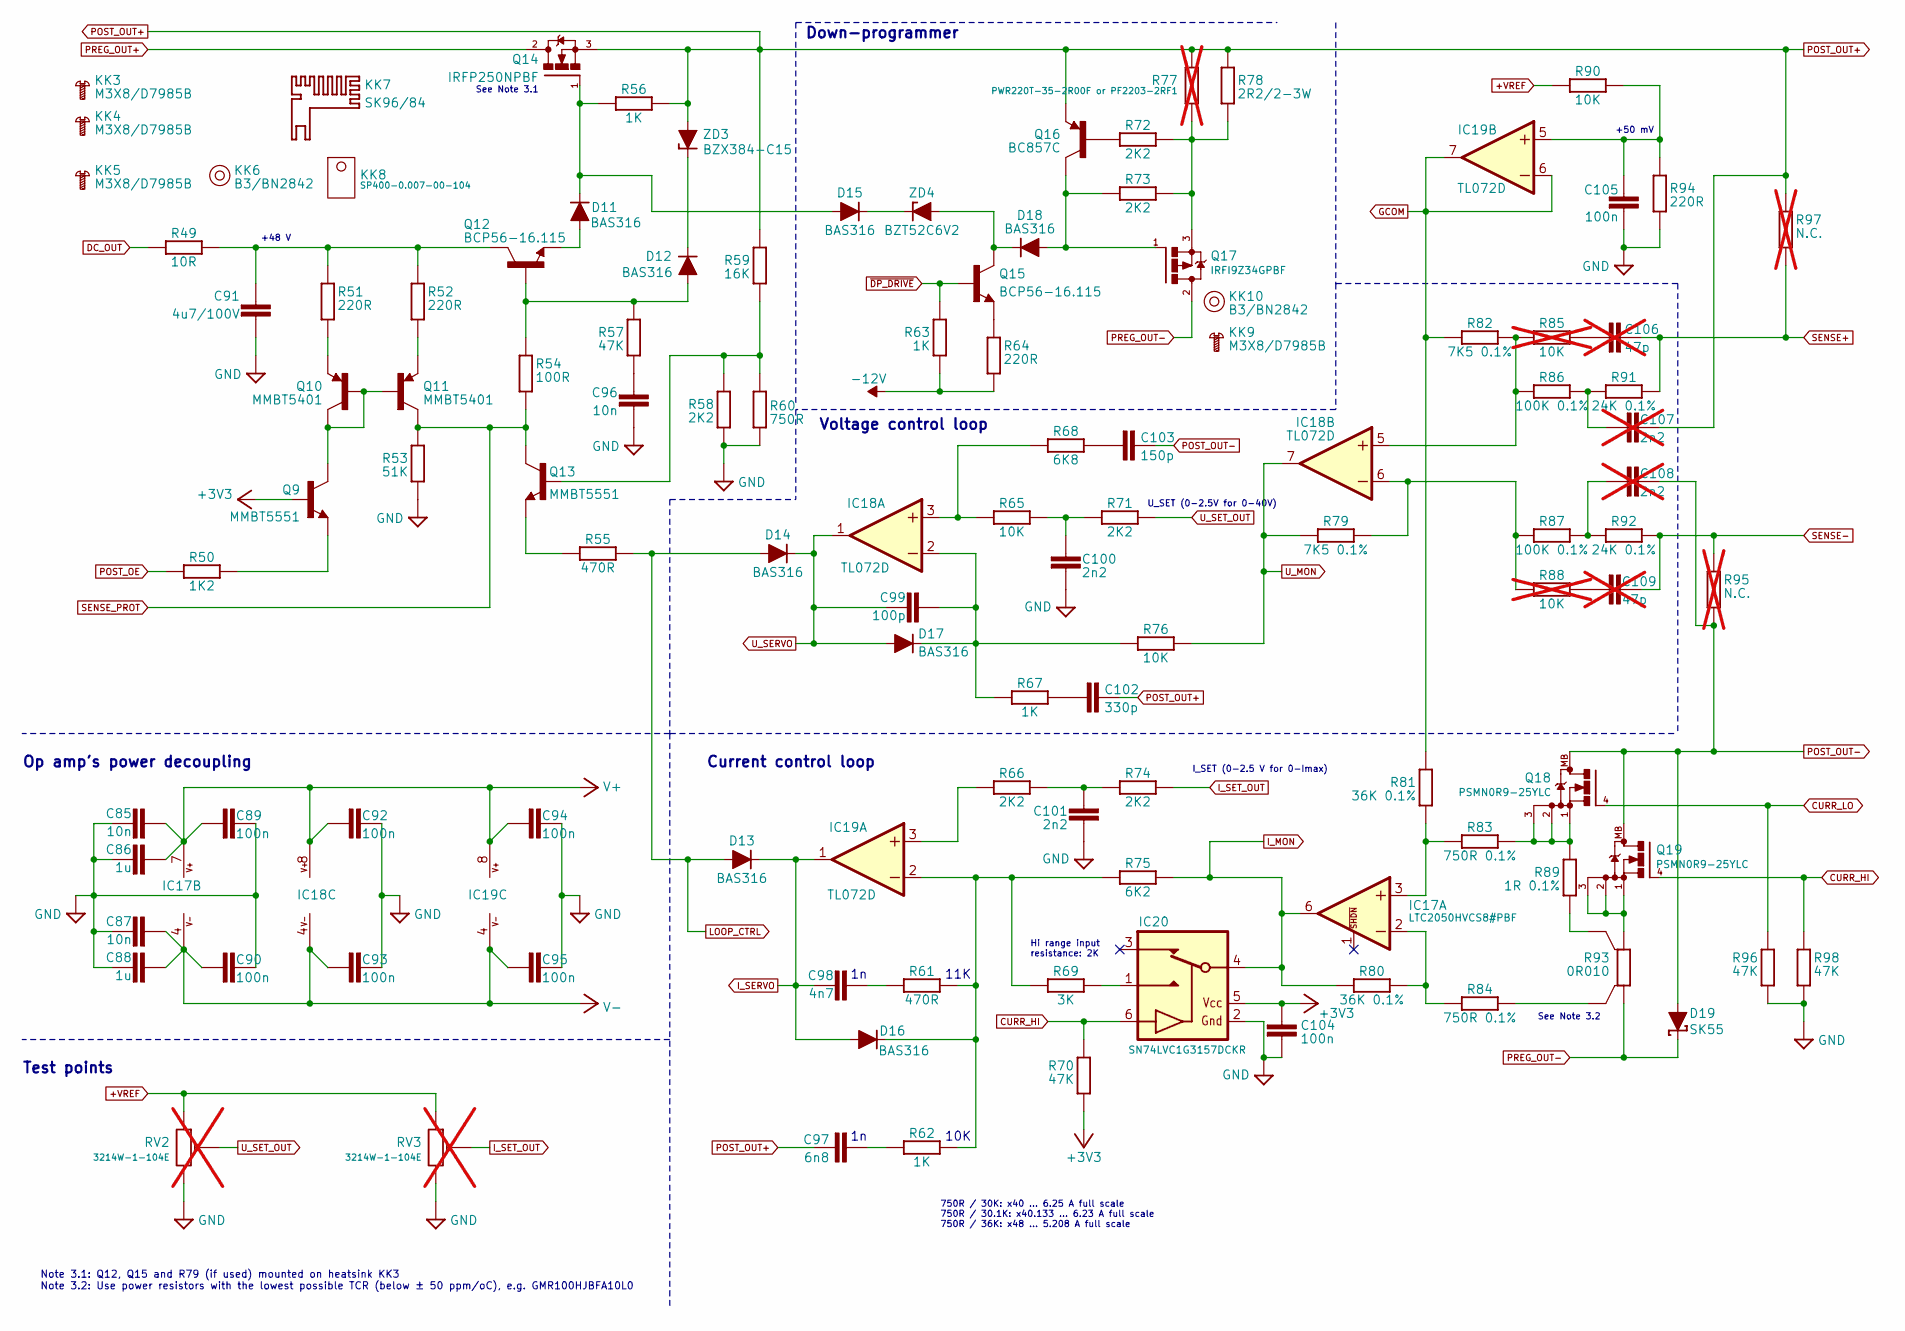
[picture p24: schematic Post-regulator.kicad_sch]

Parts:
C85, C87, C96: 10n; C_0805_2012Metric; DigiKey 490-7194-1-ND
C86, C88: 1u; C_0805_2012Metric; DigiKey 587-1283-1-ND
C89, C90, C92, C93, C94, C95, C104, C105: 100n; C_0603_1608Metric; DigiKey 490-4774-1-ND
C91: 4u7/100V; C_1210_3225Metric; DigiKey 587-5034-1-ND
C97: 6n8; C_0805_2012Metric; DigiKey 1276-1799-1-ND
C98: 4n7; C_0805_2012Metric; DigiKey 732-12255-1-ND
C99: 100p; C_0805_2012Metric; DigiKey 399-15000-1-ND
C100, C101: 2n2; C_0805_2012Metric; DigiKey 399-C0805C222K5RAC7210TR-ND
C102: 330p; C_0805_2012Metric; DigiKey 1276-1189-1-ND
C103: 150p; C_0805_2012Metric; DigiKey 1276-1828-1-ND
C106, C109: 47p; C_0805_2012Metric; not fitted
C107, C108: 2n2; C_0805_2012Metric; DigiKey 399-C0805C222K5RAC7210TR-ND; not fitted
D11, D12, D13, D14, D15, D16, D17, D18: BAS316; SOD-323_1P8X1P35_ONS-M; DigiKey 1727-7370-1-ND
D19: SK55; DO214AA; DigiKey SK56A-LTPMSCT-ND
IC17: LTC2050HVCS8#PBF; SOIC127P600X173-8N; DigiKey LTC2050HVCS8#PBF-ND
IC18, IC19: TL072D; SOIC127P600X173-8N; DigiKey 296-1282-1-ND
IC20: SN74LVC1G3157DCKR; SOT65P210X110-6N; DigiKey 296-14909-1-ND
KK3, KK4, KK5, KK9: M3X8/D7985B
KK6, KK10: B3/BN2842
KK7: SK96/84; SK96_84; DigiKey 5496-SK9684SA-ND
KK8: SP400-0.007-00-104; DigiKey BER204-ND
Q9, Q13: MMBT5551; SOT23-BEC; DigiKey MMBT5551LT1GOSCT-ND
Q10, Q11: MMBT5401; SOT23-BEC; DigiKey MMBT5401-FDICT-ND
Q12, Q15: BCP56-16.115; SOT223-BCE; DigiKey BCP5616QTADICT-ND
Q14: IRFP250NPBF; TO247-3_SUNKEN; DigiKey IRFP250NPBF-ND
Q16: BC857C; SOT23-BEC; DigiKey 4878-BC857CCT-ND
Q17: IRFI9Z34GPBF; TO220FP-V; DigiKey IRFI9Z34GPBF-ND
Q18, Q19: PSMN0R9-25YLC; SOT669; DigiKey 1727-5292-1-ND
R49: 10R; R_0805_2012Metric
R50: 1K2; R_0805_2012Metric
R51, R52, R64, R94: 220R; R_0805_2012Metric; DigiKey RMCF0805FT220RCT-ND
R53: 51K; R_0805_2012Metric
R54: 100R; R_0603_1608Metric; DigiKey 13-RC0603FR-10100RLCT-ND
R55, R61: 470R; R_0805_2012Metric; DigiKey 311-470CRCT-ND
R56, R62, R63, R67: 1K; R_0805_2012Metric; DigiKey RC0805FR-071KL
R57, R70, R96, R98: 47K; R_0805_2012Metric; DigiKey RHM47KKCT-ND
R58, R66, R71, R72, R73, R74: 2K2; R_0805_2012Metric; DigiKey 311-2.20KCRCT-ND
R59: 16K; R_0805_2012Metric
R60: 750R; R_0805_2012Metric; DigiKey A126385CT-ND
R65, R76, R90: 10K; R_0805_2012Metric; DigiKey 311-10.0KCRCT-ND
R68: 6K8; R_0805_2012Metric
R69: 3K; R_0603_1608Metric
R75: 6K2; R_0805_2012Metric
R77: PWR220T-35-2R00F or PF2203-2RF1; TO220-2-V; DigiKey 696-1313-ND; not fitted
R78: 2R2/2-3W; R_2512_6332Metric; DigiKey CRM2512-JW-2R2ELFCT-ND
R79, R82: 7K5 0.1%; R_0805_2012Metric; DigiKey YAG1974CT-ND
R80, R81: 36K 0.1%; R_0805_2012Metric; DigiKey YAG4886CT-ND
R83, R84: 750R 0.1%; R_0805_2012Metric; DigiKey YAG4940CT-ND
R85, R88: 10K; R_0805_2012Metric; not fitted
R86, R87: 100K 0.1%; R_0805_2012Metric
R89: 1R 0.1%; R_1206_3216Metric; DigiKey 1712-CPF1206B1R0E1CT-ND
R91, R92: 24K 0.1%; R_0805_2012Metric
R93: 0R010; R_2512-4WIRE; DigiKey 846-GMR100HJBFA10L0CT-ND
R95, R97: N.C.; R_0805_2012Metric; not fitted
RV2, RV3: 3214W-1-104E; TRIM_3214W-1-104E; DigiKey 3214W-104ECT-ND; not fitted
ZD3: BZX384-C15; SOD-323_1P8X1P35_ONS-M; DigiKey 1727-4986-1-ND
ZD4: BZT52C6V2; SOD123; DigiKey 4878-BZT52C6V2CT-ND

Connections:
+3V3: C104.1, IC20.5 (VDD), Q9.B, R70.1
+VREF: R90.1, RV2.1, RV3.1
-12V: R63.2, R64.2
CURR_HI: IC20.6 (CTRL), Q19.4 (G), R70.2, R98.2
CURR_LO: Q18.4 (G), R96.2
DC_OUT: R49.2
GCOM: IC19.6 (-IN), IC19.7 (OUT), R81.1, R82.1
GND: C85.1, C86.1, C87.1, C88.1, C89.2, C90.2, C91.2, C92.1, C93.1, C94.1, C95.1, C96.2, C100.2, C101.2, C104.2, C105.2, IC20.2 (GND), R53.1, R58.1, R60.1, R94.2, R96.1, R98.1, RV2.3, RV3.3
I_MON: IC17.6 (OUT), IC20.4 (COM), R75.1, R80.2
I_SERVO: C98.2, D13.C, D16.A, IC19.1 (OUT)
I_SET_OUT: R74.1, RV3.2
LOOP_CTRL: D13.A, D14.A, R55.1
unnamed: C91.1, Q12.C, R49.1, R51.2, R52.2
unnamed: C96.1, R57.1
unnamed: C97.2, R62.1
unnamed: C98.1, R61.1
unnamed: C99.1, D17.C, IC18.2 (-IN), R67.2, R76.2
unnamed: C100.1, R65.1, R71.2
unnamed: C101.1, R66.1, R74.2
unnamed: C102.2, R67.1
unnamed: C103.2, R68.1
unnamed: C105.1, IC19.5 (+IN), R90.2, R94.1
unnamed: C106.2, R85.1
unnamed: C107.1, R86.2, R91.1
unnamed: C108.1, R87.2, R92.1
unnamed: C109.2, R88.1
unnamed: D11.A, Q12.E
unnamed: D11.C, D15.A, Q14.1 (G), R56.1
unnamed: D12.A, Q12.B, R54.1, R57.2
unnamed: D12.C, ZD3.C
unnamed: D15.C, ZD4.C
unnamed: D16.C, IC19.2 (-IN), R61.2, R62.2, R69.2, R75.2
unnamed: D18.A, Q16.C, Q17.1 (G), R73.2
unnamed: D18.C, Q15.C, ZD4.A
unnamed: IC17.2 (-IN), R80.1, R84.2
unnamed: IC17.3 (+IN), R81.2, R83.2
unnamed: IC18.3 (+IN), R65.2, R68.2
unnamed: IC18.5 (+IN), R82.2, R85.2, R86.1
unnamed: IC18.6 (-IN), R79.2, R87.1, R88.2
unnamed: IC19.3 (+IN), R66.2
unnamed: IC20.1 (NO), R69.1
unnamed: Q9.E, R50.2
unnamed: Q9.C, Q10.B, Q10.C, Q11.B
unnamed: Q10.E, R51.1
unnamed: Q11.E, R52.1
unnamed: Q13.B, R58.2, R59.1, R60.2
unnamed: Q13.E, R55.2
unnamed: Q15.E, R64.1
unnamed: Q16.B, R72.2
unnamed: Q17.3 (S), R72.1, R73.1, R77.1, R78.2
unnamed: Q18.1 (S), Q18.2 (S), Q18.3 (S), R83.1, R89.2
unnamed: Q19.1 (S), Q19.2 (S), Q19.3 (S), R93.2
unnamed: R84.1, R93.1S
unnamed: R89.1, R93.2S
POST_OE: R50.1
POST_OUT+: C97.1, C102.1, C107.2, Q14.3 (S), Q16.E, R56.2, R59.2, R77.2, R78.1, R97.1, ZD3.A
POST_OUT-: C103.1, C108.2, D19.A, Q18.MB, Q19.MB, R95.2
PREG_OUT+: Q14.2 (D)
PREG_OUT-: D19.C, Q17.2 (D), R93.1
SENSE+: C106.1, R91.2, R97.2
SENSE-: C109.1, R92.2, R95.1
SENSE_PROT: Q11.C, Q13.C, R53.2, R54.2
U_MON: IC18.7 (OUT), R76.1, R79.1
U_SERVO: C99.2, D14.C, D17.A, IC18.1 (OUT)
U_SET_OUT: R71.1, RV2.2
V+: C85.2, C86.2, C89.1, C92.2, C94.2, IC17.7 (V+), IC18.8 (V+), IC19.8 (V+)
V-: C87.2, C88.2, C90.1, C93.2, C95.2, IC17.4 (V-), IC18.4 (V-), IC19.4 (V-)
~DP_DRIVE: Q15.B, R63.1

Notes on the sheet:
Hi range input resistance: 2K
11K
Down-programmer
+50 mV
I_SET (0-2.5 V for 0-Imax)
Op amp's power decoupling
See Note 3.1
10K
Current control loop
Voltage control loop
See Note 3.2
+48 V
U_SET (0-2.5V for 0-40V)
Test points
750R / 30K: x40 ... 6.25 A full scale 750R / 30.1K: x40.133 ... 6.23 A full scale 750R / 36K: x48 ... 5.208 A full scale
Note 3.1: Q12, Q15 and R79 (if used) mounted on heatsink KK3 Note 3.2: Use power resistors with the lowest possible TCR (below ± 50 ppm/oC), e.g. GMR100HJBFA10L0
