s070388s/dib-dcp405plus-/KiCad/Power_pre-regulator.kicad_sch

## KiCad design KiCad/Power_pre-regulator.kicad_sch (2025-12-18, an earlier design)

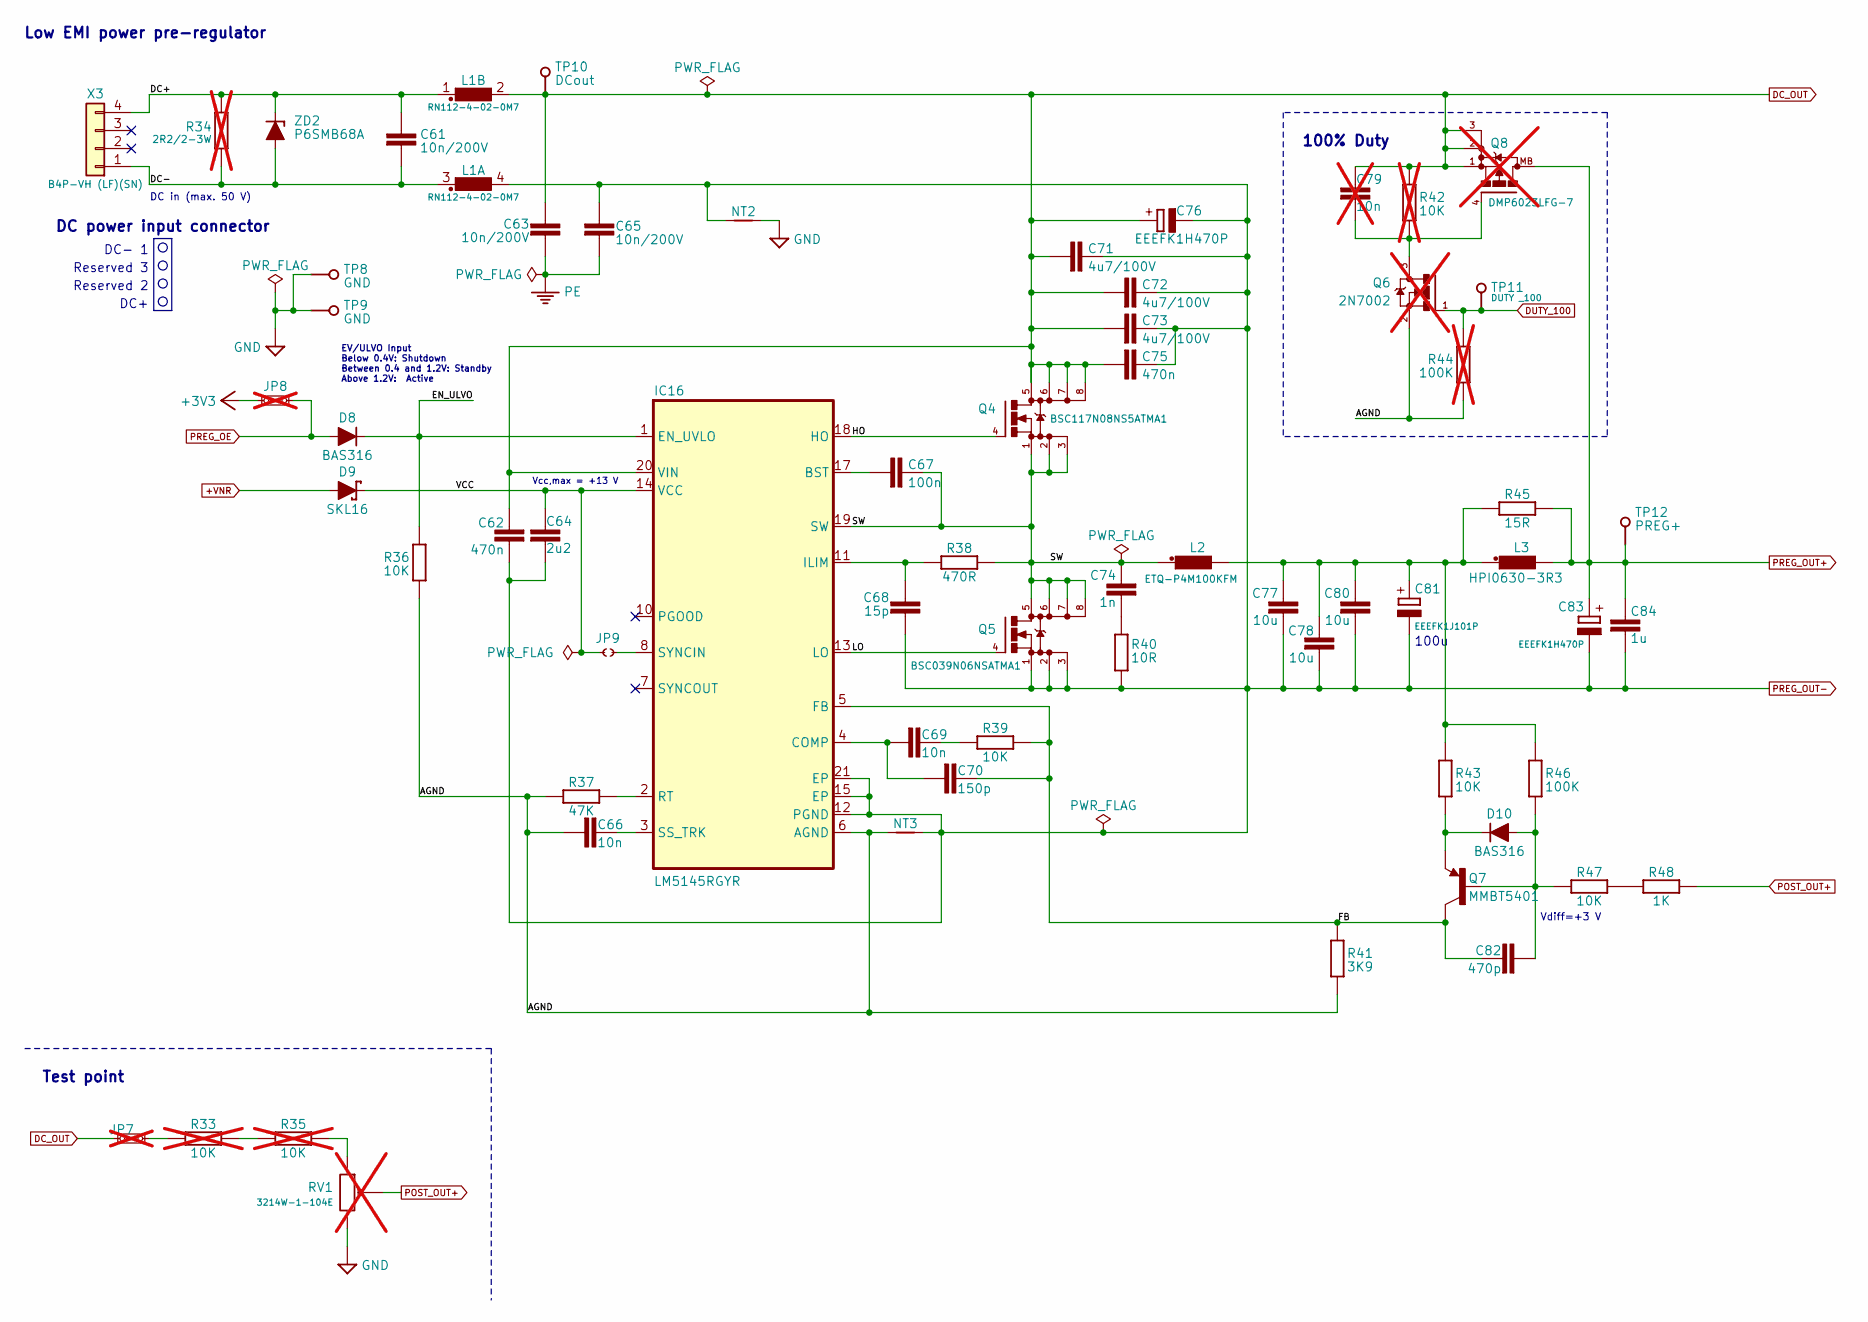
[picture p25: schematic Power_pre-regulator.kicad_sch]

Parts:
C61, C63, C65: 10n/200V; C_1206_3216Metric; DigiKey 311-4491-1-ND
C62, C75: 470n; C_0805_2012Metric; DigiKey 1276-6482-1-ND
C64: 2u2; C_1206_3216Metric; DigiKey 1276-3138-1-ND
C66, C69: 10n; C_0805_2012Metric; DigiKey 490-7194-1-ND
C67: 100n; C_0603_1608Metric; DigiKey 490-4774-1-ND
C68: 15p; C_0603_1608Metric; DigiKey 399-C0603C150J5GAC7867TR-ND
C70: 150p; C_0805_2012Metric; DigiKey 1276-1828-1-ND
C71, C72, C73: 4u7/100V; C_1210_3225Metric; DigiKey 587-5034-1-ND
C74: 1n; C_0603_1608Metric; DigiKey 732-7858-1-ND
C76, C83: EEEFK1H470P; CAPAE830X1050N; DigiKey PCE3815CT-ND
C77, C78, C80: 10u; C_1210_3225Metric; DigiKey 1276-6736-1-ND
C79: 10n; C_0805_2012Metric; DigiKey 490-7194-1-ND; not fitted
C81: EEEFK1J101P; CAPAE1030X1050N; DigiKey PCE3819CT-ND
C82: 470p; C_0805_2012Metric; DigiKey 732-7837-1-ND
C84: 1u; C_0805_2012Metric; DigiKey 587-1283-1-ND
D8, D10: BAS316; SOD-323_1P8X1P35_ONS-M; DigiKey 1727-7370-1-ND
D9: SKL16; SOD123; DigiKey RB160MM-60CT-ND
IC16: LM5145RGYR; RGY0020B; DigiKey 296-47661-1-ND
JP7, JP8: M22-2010246; DigiKey M22-2010346-ND; not fitted
JP9: JP2-CUT-0805; JP2 open (0603)
L1: RN112-4-02-0M7; RN112; DigiKey 817-2100-ND
L2: ETQ-P4M100KFM; PANASONIC_ETQ-P4_KFM; DigiKey P124167CT-ND
L3: HPI0630-3R3; COILCRAFT_HPI0630; DigiKey 445-180834-1-ND
NT2: NetTie_2; NetTie-2_SMD_Pad1.5mm
NT3: NetTie_2; NetTie-2_SMD_Pad0.2mm
Q4: BSC117N08NS5ATMA1; TDSON-8; DigiKey BSC117N08NS5ATMA1CT-ND
Q5: BSC039N06NSATMA1; TDSON-8; DigiKey BSC039N06NSATMA1CT-ND
Q6: 2N7002; SOT103P240X110-3N; DigiKey T2N7002AKLMCT-ND; not fitted
Q7: MMBT5401; SOT23-BEC; DigiKey MMBT5401-FDICT-ND
Q8: DMP6023LFG-7; TRANS_FDMC8010; DigiKey DMP6023LFG-7DICT-ND; not fitted
R33, R35, R42: 10K; R_0805_2012Metric; DigiKey 311-10.0KCRCT-ND; not fitted
R34: 2R2/2-3W; R_2512_6332Metric; DigiKey CRM2512-JW-2R2ELFCT-ND; not fitted
R36, R39, R43, R47: 10K; R_0805_2012Metric; DigiKey 311-10.0KCRCT-ND
R37: 47K; R_0805_2012Metric; DigiKey RHM47KKCT-ND
R38: 470R; R_0805_2012Metric; DigiKey 311-470CRCT-ND
R40: 10R; R_0805_2012Metric
R41: 3K9; R_0805_2012Metric; DigiKey A126369CT-ND
R44: 100K; R_0805_2012Metric; DigiKey RMCF0805FT100KCT-ND; not fitted
R45: 15R; R_2010_5025Metric; DigiKey A129910CT-ND
R46: 100K; R_0805_2012Metric; DigiKey RMCF0805FT100KCT-ND
R48: 1K; R_0805_2012Metric; DigiKey RC0805FR-071KL
RV1: 3214W-1-104E; TRIM_3214W-1-104E; DigiKey 3214W-104ECT-ND; not fitted
TP8, TP9: PCB_TEST_TABSHIELD; Testhole 24_50mils
TP10, TP11, TP12: TEST-PIN_0.9MM; Testhole 24_50mils
X3: B4P-VH (LF)(SN); B4P-VH_LF_SN
ZD2: P6SMB68A; DO214AA; DigiKey P6SMB68ABBCT-ND

Connections:
+3V3: JP8.1
+VNR: D9.A
AGND: C66.2, IC16.6 (AGND), NT3.1, Q6.2 (S), R36.1, R37.1, R41.2, R44.2
DC+: C61.2, L1.1, R34.1, X3.4, ZD2.C
DC-: C61.1, L1.3 (1), R34.2, X3.1, ZD2.A
DC_OUT: C62.2, C63.2, C71.1, C72.1, C73.1, C75.2, C76.+, C79.1, IC16.20 (VIN), JP7.1, L1.2, Q4.5 (D), Q4.6 (S), Q4.7 (S), Q4.8 (S), Q8.1 (S), Q8.2 (S), Q8.3 (S), R42.2, TP10.1
DUTY_100: Q6.1 (G), R44.1, TP11.1
EN_ULVO: D8.C, IC16.1 (EN_UVLO), R36.2
FB: C70.1, C82.1, IC16.5 (FB), Q7.C, R39.2, R41.1
GND: NT2.2, RV1.3, TP8.1, TP9.1
HO: IC16.18 (HO), Q4.4 (G)
LO: IC16.13 (LO), Q5.4 (G)
unnamed: C66.1, IC16.3 (SS_TRK)
unnamed: C67.1, IC16.17 (BST)
unnamed: C68.1, IC16.11 (ILIM), R38.1
unnamed: C69.1, R39.1
unnamed: C69.2, C70.2, IC16.4 (COMP)
unnamed: C74.2, R40.2
unnamed: C77.1, C78.1, C80.1, C81.+, L2.2, L3.1, R43.1, R45.2, R46.1
unnamed: C79.2, Q6.3 (D), Q8.4 (G), R42.1
unnamed: C82.2, D10.A, Q7.B, R46.2, R47.1
unnamed: D10.C, Q7.E, R43.2
unnamed: IC16.2 (RT), R37.2
unnamed: IC16.8 (SYNCIN), JP9.2
unnamed: JP7.2, R33.2
unnamed: R33.1, R35.2
unnamed: R35.1, RV1.1
unnamed: R47.2, R48.1
PE: C63.1, C65.2
POST_OUT+: R48.2, RV1.2
PREG_OE: D8.A, JP8.2
PREG_OUT+: C83.+, C84.2, L3.2, Q8.MB, R45.1, TP12.1
PREG_OUT-: C62.1, C64.1, C65.1, C68.2, C71.2, C72.2, C73.2, C75.1, C76.-, C77.2, C78.2, C80.2, C81.-, C83.-, C84.1, IC16.12 (PGND), IC16.15 (EP), IC16.21 (EP), L1.4 (2), NT2.1, NT3.2, Q5.1 (S), Q5.2 (S), Q5.3 (S), R40.1
SW: C67.2, C74.1, IC16.19 (SW), L2.1, Q4.1 (S), Q4.2 (S), Q4.3 (S), Q5.5 (D), Q5.6 (S), Q5.7 (S), Q5.8 (S), R38.2
VCC: C64.2, D9.C, IC16.14 (VCC), JP9.1

Notes on the sheet:
DC- 1
Reserved 2
Low EMI power pre-regulator
DC+
Vcc,max = +13 V
Reserved 3
DC in (max. 50 V)
100% Duty
Vdiff=+3 V
Test point
DC power input connector
100u
EV/ULVO Input Below 0.4V: Shutdown Between 0.4 and 1.2V: Standby Above 1.2V: Active
