s070388s/dib-dcp405plus-/KiCad/Rsense_protection_power_output.kicad_sch

## KiCad design KiCad/Rsense_protection_power_output.kicad_sch (2025-12-18, an earlier design)

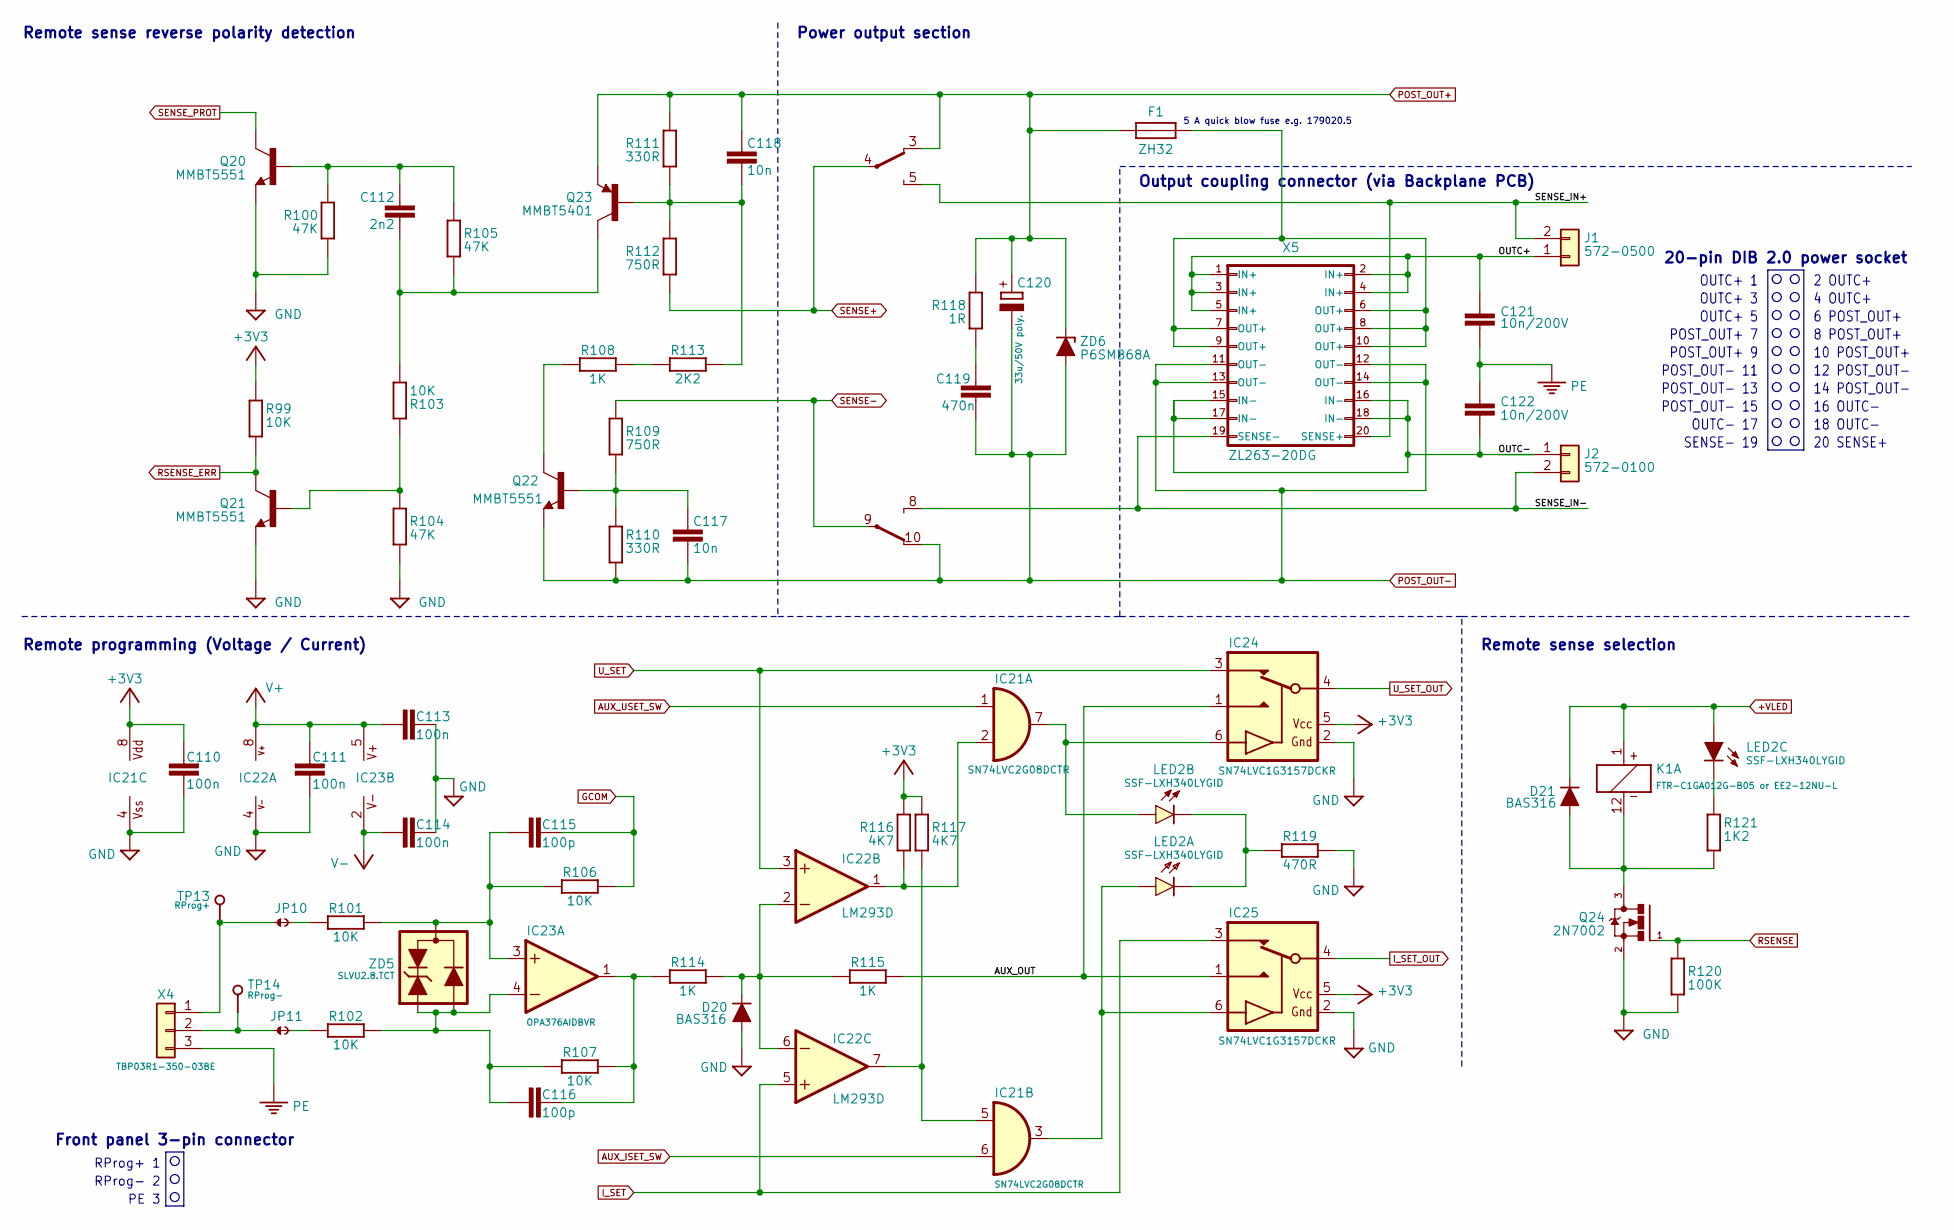
[picture p26: schematic Rsense_protection_power_output.kicad_sch]

Parts:
C110, C111, C113, C114: 100n; C_0603_1608Metric; DigiKey 490-4774-1-ND
C112: 2n2; C_0805_2012Metric; DigiKey 399-C0805C222K5RAC7210TR-ND
C115, C116: 100p; C_0805_2012Metric; DigiKey 399-15000-1-ND
C117, C118: 10n; C_0805_2012Metric; DigiKey 490-7194-1-ND
C119: 470n; C_0805_2012Metric; DigiKey 1276-6482-1-ND
C120: 33u/50V poly.; CAPAE830X1050N; DigiKey 565-HHXD630ARA330MHA0GCT-ND
C121, C122: 10n/200V; C_1206_3216Metric; DigiKey 311-4491-1-ND
D20, D21: BAS316; SOD-323_1P8X1P35_ONS-M; DigiKey 1727-7370-1-ND
F1: ZH32; DigiKey 732-11370-ND
IC21: SN74LVC2G08DCTR; DCT8; DigiKey 296-13263-2-ND
IC22: LM293D; SOIC127P600X173-8N; DigiKey LM293DR2GOSCT-ND
IC23: OPA376AIDBVR; SOT23-5L_STM; DigiKey 296-39130-2-ND
IC24, IC25: SN74LVC1G3157DCKR; SOT65P210X110-6N; DigiKey 296-14909-1-ND
J1: 572-0500; 572-0X00; Mouser 164-6221
J2: 572-0100; 572-0X00; Mouser 164-6220
JP10, JP11: JP2-NOCUT-0805; JP2 shorted (0603)
K1: FTR-C1GA012G-B05 or EE2-12NU-L; FTR-C1; DigiKey 399-10997-1-ND
LED2: SSF-LXH340LYGID; DigiKey SSF-LXH340LYGID-ND
Q20, Q21, Q22: MMBT5551; SOT23-BEC; DigiKey MMBT5551LT1GOSCT-ND
Q23: MMBT5401; SOT23-BEC; DigiKey MMBT5401-FDICT-ND
Q24: 2N7002; SOT103P240X110-3N; DigiKey T2N7002AKLMCT-ND
R99, R101, R102, R103, R106, R107: 10K; R_0805_2012Metric; DigiKey 311-10.0KCRCT-ND
R100, R104, R105: 47K; R_0805_2012Metric; DigiKey RHM47KKCT-ND
R108, R114, R115: 1K; R_0805_2012Metric; DigiKey RC0805FR-071KL
R109, R112: 750R; R_0805_2012Metric; DigiKey A126385CT-ND
R110, R111: 330R; R_0805_2012Metric; DigiKey A129743CT-ND
R113: 2K2; R_0805_2012Metric; DigiKey 311-2.20KCRCT-ND
R116, R117: 4K7; R_0805_2012Metric; DigiKey 311-4.70KCRCT-ND
R118: 1R; R_0805_2012Metric
R119: 470R; R_0805_2012Metric; DigiKey 311-470CRCT-ND
R120: 100K; R_0805_2012Metric; DigiKey RMCF0805FT100KCT-ND
R121: 1K2; R_0805_2012Metric
TP13, TP14: PCB_TEST_TABSHIELD; Testhole 24_50mils
X4: TBP03R1-350-03BE; DigiKey 2223-TBP03R1-350-03BE-ND
X5: ZL263-20DG; SSW-110-02-T-D-RA; DigiKey PPPC102LJBN-RC
ZD5: SLVU2.8.TCT; SOT23-3; DigiKey CDSOT23-SLVU2.8TR-ND
ZD6: P6SMB68A; DO214AA; DigiKey P6SMB68ABBCT-ND

Connections:
+3V3: C110.2, IC21.8 (VDD), IC24.5 (VDD), IC25.5 (VDD), R99.2, R116.1, R117.1
+VLED: D21.C, K1.1 (C1), LED2.YA
AUX_ISET_SW: IC21.6 (I1)
AUX_OUT: IC24.1 (NO), IC25.1 (NO), R115.1
AUX_USET_SW: IC21.1 (I0)
GCOM: C115.1, R106.1
GND: C110.1, C111.2, C113.2, C114.2, D20.A, IC21.4 (VSS), IC22.4 (V-), IC24.2 (GND), IC25.2 (GND), Q20.E, Q21.E, Q24.2 (S), R100.1, R104.1, R119.1, R120.1
I_SET: IC22.5 (+IN), IC25.3 (NC)
I_SET_OUT: IC25.4 (COM)
unnamed: C112.1, Q20.B, R100.2, R105.2
unnamed: C112.2, Q23.C, R103.2, R105.1
unnamed: C115.2, IC23.3 (+IN), R101.1, R106.2, ZD5.3
unnamed: C116.1, IC23.1 (OUT), R107.1, R114.2
unnamed: C116.2, IC23.4 (-IN), R102.1, R107.2, ZD5.1, ZD5.2
unnamed: C117.1, Q22.B, R109.1, R110.2
unnamed: C118.2, Q23.B, R111.1, R112.2, R113.2
unnamed: C119.2, R118.2
unnamed: D20.C, IC22.2 (-IN), IC22.6 (-IN), R114.1, R115.2
unnamed: D21.A, K1.12 (C2), Q24.3 (D), R121.1
unnamed: F1.2, X5.6 (OUT+), X5.7 (OUT+), X5.8 (OUT+), X5.9 (OUT+), X5.10 (OUT+)
unnamed: IC21.2 (I1), IC22.1 (OUT), R116.2
unnamed: IC21.3 (O), IC25.6 (CTRL), LED2.RA
unnamed: IC21.5 (I0), IC22.7 (OUT), R117.2
unnamed: IC21.7 (O), IC24.6 (CTRL), LED2.GA
unnamed: JP10.1, TP13.1, X4.1
unnamed: JP10.2, R101.2
unnamed: JP11.1, TP14.1, X4.2
unnamed: JP11.2, R102.2
unnamed: LED2.GC, LED2.RC, R119.2
unnamed: LED2.YC, R121.2
unnamed: Q21.B, R103.1, R104.2
unnamed: Q22.C, R108.1
unnamed: R108.2, R113.1
OUTC+: C121.1, J1.1, X5.1 (IN+), X5.2 (IN+), X5.3 (IN+), X5.4 (IN+), X5.5 (IN+)
OUTC-: C122.2, J2.1, X5.15 (IN-), X5.16 (IN-), X5.17 (IN-), X5.18 (IN-)
PE: C121.2, C122.1, X4.3
POST_OUT+: C118.1, C120.+, F1.1, K1.3 (NC), Q23.E, R111.2, R118.1, ZD6.C
POST_OUT-: C117.2, C119.1, C120.-, K1.10 (NC), Q22.E, R110.1, X5.11 (OUT-), X5.12 (OUT-), X5.13 (OUT-), X5.14 (OUT-), ZD6.A
RSENSE: Q24.1 (G), R120.2
RSENSE_ERR: Q21.C, R99.1
SENSE+: K1.4 (COM), R112.1
SENSE-: K1.9 (COM), R109.2
SENSE_IN+: J1.2, K1.5 (NO), X5.20 (SENSE+)
SENSE_IN-: J2.2, K1.8 (NO), X5.19 (SENSE-)
SENSE_PROT: Q20.C
U_SET: IC22.3 (+IN), IC24.3 (NC)
U_SET_OUT: IC24.4 (COM)
V+: C111.1, C113.1, IC22.8 (V+), IC23.5 (V+)
V-: C114.1, IC23.2 (V-)

Notes on the sheet:
8 POST_OUT+
PE 3
16 OUTC-
POST_OUT- 11
12 POST_OUT-
Remote sense reverse polarity detection
POST_OUT+ 9
OUTC- 17
Output coupling connector (via Backplane PCB)
POST_OUT- 13
Remote programming (Voltage / Current)
10 POST_OUT+
4 OUTC+
6 POST_OUT+
2 OUTC+
OUTC+ 5
14 POST_OUT-
18 OUTC-
POST_OUT+ 7
OUTC+ 1
RProg+ 1
20 SENSE+
Front panel 3-pin connector
OUTC+ 3
5 A quick blow fuse e.g. 179020.5
RProg- 2
Power output section
Remote sense selection
SENSE- 19
POST_OUT- 15
20-pin DIB 2.0 power socket
