s070388s/dib-dcp405plus-/CubeMX/EEZ DIB DCP405plus.ioc

Mcu.UserName=STM32H503CBTx
PA0.GPIO_Label=DIB_MISO
PA0.Signal=SPI1_MISO
PA1.GPIO_Label=DIB_CSA
PA1.Signal=SPI1_NSS
PA10.GPIO_Label=DIB_FAULT
PA10.Signal=GPIO_Output
PA11.Signal=USB_DM
PA12.Signal=USB_DP
PA13(JTMS/SWDIO).GPIO_Label=JTAG_DIO
PA13(JTMS/SWDIO).Signal=DEBUG_JTMS-SWDIO
PA14(JTCK/SWCLK).GPIO_Label=JTAG_CLK
PA14(JTCK/SWCLK).Signal=DEBUG_JTCK-SWCLK
PA15(JTDI).GPIO_Label=SCLK1
PA15(JTDI).Signal=SPI3_SCK
PA2.GPIO_Label=DIB_CLK
PA2.Signal=SPI1_SCK
PA3.GPIO_Label=MOSI1
PA3.Signal=SPI3_MOSI
PA4.GPIO_Label=DIB_MOSI
PA4.Signal=SPI1_MOSI
PA5.GPIO_Label=ADC_SCLK
PA5.Signal=SPI2_SCK
PA6.GPIO_Label=IOEXP_IRQ
PA6.Signal=GPXTI6
PA7.GPIO_Label=ADC_MISO
PA7.Signal=SPI2_MISO
PA8.GPIO_Label=ADC_CS
PA8.Signal=SPI2_NSS
PA9.GPIO_Label=DAC_CS
PA9.Signal=GPIO_Output
PB0.GPIO_Label=DIB_IRQ
PB0.Signal=GPXTI0
PB1.GPIO_Label=ADC_MOSI
PB1.Signal=SPI2_MOSI
PB10.GPIO_Label=DIB_SDA
PB10.Signal=I2C1_SDA
PB12.GPIO_Label=IOEXP_CS
PB12.Signal=GPIO_Output
PB13.GPIO_Label=DIB_ALERT
PB13.Signal=I2C1_SMBA
PB14.Signal=USART1_TX
PB15.GPIO_Label=MISO1
PB15.Signal=SPI3_MISO
PB2.GPIO_Label=ADC_IRQ
PB2.Signal=GPXTI2
PB3(JTDO/TRACESWO).GPIO_Label=JTAG_SWO
PB3(JTDO/TRACESWO).Signal=DEBUG_JTDO-SWO
PB4(NJTRST).GPIO_Label=AC_FREQ
PB4(NJTRST).Signal=S_TIM1_CH2
PB6.GPIO_Label=DIB_SCL
PB6.Signal=I2C1_SCL
PB7.Signal=USART1_RX
PB8.GPIO_Label=TEMP_CS
PB8.Signal=GPIO_Output
PC13.GPIO_Label=ACT_LED
PC13.Signal=GPIO_Output
PH0-OSC_IN(PH0).Signal=RCC_OSC_IN
PH1-OSC_OUT(PH1).Signal=RCC_OSC_OUT
