s070388s/dib-dcp405plus-/(commit log)

2025-11-12 minor PCB layout changes, ibom added
    [EEZ DIB DCP405plus-B_Cu.gbr, EEZ DIB DCP405plus-B_Mask.gbr, EEZ DIB DCP405plus-B_Paste.gbr, EEZ DIB DCP405plus-B_Silkscreen.gbr, EEZ DIB DCP405plus-Edge_Cuts.gbr, EEZ DIB DCP405plus-F_Cu.gbr, EEZ DIB DCP405plus-F_Mask.gbr, EEZ DIB DCP405plus-F_Paste.gbr]
2025-11-21 r4B3 version: OE fixed, new LEDs for remote programming
    [Bias_power.kicad_sch, CC_CV_OVP.kicad_sch, DAC_Vref_IOEXP_Temp.kicad_sch, DIB_EEPROM_ADC_MCU.kicad_sch, EEZ DIB DCP405plus front mask-Edge_Cuts.dxf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]
2025-11-23 Front mask gerbers and dxf update
    [Bias_power.kicad_sch, CC_CV_OVP.kicad_sch, DAC_Vref_IOEXP_Temp.kicad_sch, DIB_EEPROM_ADC_MCU.kicad_sch, EEZ DIB DCP405plus front mask-Edge_Cuts.dxf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]
2025-11-23 Front mask project info update
    [EEZ DIB DCP405plus front mask.kicad_pcb]
2025-11-27 BOM update
    [Bias_power.kicad_sch, CC_CV_OVP.kicad_sch, DAC_Vref_IOEXP_Temp.kicad_sch, DIB_EEPROM_ADC_MCU.kicad_sch, EEZ DIB DCP405plus.kicad_sch, EEZ DIB DCP405plus.ods, Post-regulator.kicad_sch, Power_pre-regulator.kicad_sch]
2025-12-05 X2 debug connector rotated
    [EEZ DIB DCP405plus-B_Cu.gbr, EEZ DIB DCP405plus-B_Mask.gbr, EEZ DIB DCP405plus-B_Paste.gbr, EEZ DIB DCP405plus-B_Silkscreen.gbr, EEZ DIB DCP405plus-Edge_Cuts.gbr, EEZ DIB DCP405plus-F_Cu.gbr, EEZ DIB DCP405plus-F_Mask.gbr, EEZ DIB DCP405plus-F_Paste.gbr]
2025-12-05 Temp sensor SPI fixed
    [Bias_power.kicad_sch, CC_CV_OVP.kicad_sch, DAC_Vref_IOEXP_Temp.kicad_sch, DIB_EEPROM_ADC_MCU.kicad_sch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]
2025-12-06 EEPROM connected to H503 I2C bus
    [Bias_power.kicad_sch, CC_CV_OVP.kicad_sch, DAC_Vref_IOEXP_Temp.kicad_sch, DIB_EEPROM_ADC_MCU.kicad_sch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]
2025-12-06 Vref tantalum capacitor removed
    [Bias_power.kicad_sch, CC_CV_OVP.kicad_sch, DAC_Vref_IOEXP_Temp.kicad_sch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]
2025-12-07 r4B4 (ADC replaced with ADS131A04)
    [Bias_power.kicad_sch, CC_CV_OVP.kicad_sch, DAC_Vref_IOEXP_Temp.kicad_sch, DIB_EEPROM_ADC_MCU.kicad_sch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]
2025-12-07 SPI channels renamed
    [DAC_Vref_IOEXP_Temp.kicad_sch, DIB_EEPROM_ADC_MCU.kicad_sch]
2025-12-07 Move DAC to SPI channel 1
    [DAC_Vref_IOEXP_Temp.kicad_sch, DIB_EEPROM_ADC_MCU.kicad_sch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]
2025-12-08 Additional 2 ch isolator added for OEP and temp sensor CS
    [Bias_power.kicad_sch, CC_CV_OVP.kicad_sch, DAC_Vref_IOEXP_Temp.kicad_sch, DIB_EEPROM_ADC_MCU.kicad_sch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]
2025-12-13 Front mask mounting holes reinforcements
    [EEZ DIB DCP405plus front mask-B_Cu.gbr, EEZ DIB DCP405plus front mask-Edge_Cuts.gbr, EEZ DIB DCP405plus front mask-F_Cu.gbr, EEZ DIB DCP405plus front mask-F_Mask.gbr, EEZ DIB DCP405plus front mask-F_Silkscreen.gbr, EEZ DIB DCP405plus front mask-NPTH.drl, EEZ DIB DCP405plus front mask-PTH.drl, EEZ DIB DCP405plus front mask-job.gbrjob]
2025-12-17 DIB_MISO and DIB_MOSI swapped
    [Bias_power.kicad_sch, CC_CV_OVP.kicad_sch, DAC_Vref_IOEXP_Temp.kicad_sch, DIB_EEPROM_ADC_MCU.kicad_sch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]
2025-12-18 OE_LED signals marked as active low
    [Bias_power.kicad_sch, CC_CV_OVP.kicad_sch, DAC_Vref_IOEXP_Temp.kicad_sch, DIB_EEPROM_ADC_MCU.kicad_sch, EEZ DIB DCP405plus.kicad_sch, Post-regulator.kicad_sch, Power_pre-regulator.kicad_sch, Rsense_protection_power_output.kicad_sch]
2025-12-27 Gerbers update
    [EEZ DIB DCP405plus-B_Cu.gbr, EEZ DIB DCP405plus-B_Mask.gbr, EEZ DIB DCP405plus-B_Paste.gbr, EEZ DIB DCP405plus-B_Silkscreen.gbr, EEZ DIB DCP405plus-Edge_Cuts.gbr, EEZ DIB DCP405plus-F_Cu.gbr, EEZ DIB DCP405plus-F_Mask.gbr, EEZ DIB DCP405plus-F_Paste.gbr]
